The-Faulty/Argos/README.md

# Argos

Argos is a low-cost search and rescue quadruped being built for Georgia Tech
Senior Design in Spring 2026. The system is split between a Raspberry Pi 4
running ROS 2 Humble and an ESP32-class controller handling the fast control loop.

## Current expo focus

The current design expo target is intentionally narrow:

- stable stand and walk
- live RPLiDAR + RealSense bring-up
- real-time mapping in RViz

Gazebo, thermal, gas mapping, and higher-level mission logic are optional
future work, not the current critical path.

## Current workspace

- `ros2_ws/src/argos_control`: ROS 2 package wrapper and node entry points
- `ros2_ws/src/argos_mission`: ROS 2 package wrapper for mission/perception bench nodes
- `ros2_ws/src/quadruped_bringup`: launch files and sensor bring-up assets
- `ros2_ws/src/argos_description`: robot description, frames, meshes, and RViz assets
- `ros2_ws/argos_control`: leg math, control helpers, and single-leg bench tools
- `ros2_ws/argos_mission`: mission state, gas hazard map, and thermal demo nodes
- `firmware/esp32c6`: ESP-IDF + micro-ROS firmware for the C6 (servos, IMU, gas)
- `dashboard`: React/Node web dashboard served from the Pi — see `docs/dashboard_guide.md`

## Physical Robot Bring-up

The repo now includes physical bring-up scripts in `quadruped_bringup`:

- `ros2 run quadruped_bringup argos_component_check preflight`
- `ros2 run quadruped_bringup argos_component_check full --include-thermal`
- `ros2 run quadruped_bringup argos_joint_jog --bidirectional`

Primary docs:

- `docs/build_guide.md`
- `docs/component_test_guide.md`
- `docs/pi_minimal_setup.md` for the current Pi + HUZZAH32, no-sensor state

## Development environment

The repo includes a Dockerfile, Docker Compose service, and VS Code devcontainer
setup for a ROS 2 Humble workflow.

Typical flow:

```bash
docker compose build
docker compose up -d
cd /workspace/ros2_ws
colcon build --symlink-install
source install/setup.bash
```

## Sensor bring-up

LiDAR only:

```bash
ros2 launch quadruped_bringup rplidar.launch.py
ros2 launch quadruped_bringup view_lidar.launch.py
```

RealSense only:

```bash
ros2 launch quadruped_bringup realsense.launch.py
ros2 launch quadruped_bringup view_camera.launch.py
```

Both sensors:

```bash
ros2 launch quadruped_bringup sensors.launch.py
```

Robot description only:

```bash
ros2 launch quadruped_bringup state_publisher.launch.py start_rviz:=true
```

Control stack only:

```bash
ros2 launch quadruped_bringup control_stack.launch.py
```

Full stack:

```bash
ros2 launch quadruped_bringup full_system.launch.py enable_esp32:=true start_rviz:=true
```

Expo demo stack:

```bash
ros2 launch quadruped_bringup expo_demo.launch.py enable_esp32:=true start_demo_commander:=true
```

Mission stack only:

```bash
ros2 launch quadruped_bringup mission_stack.launch.py
```

Full stack with mission nodes:

```bash
ros2 launch quadruped_bringup full_system.launch.py enable_esp32:=true enable_mission:=true start_rviz:=true
```

## Web dashboard

The dashboard replaces the retired `web/leg_viz/` single-leg tool with a
full-robot control + telemetry panel. Launch it with the rest of the
stack:

```bash
ros2 launch quadruped_bringup full_system.launch.py enable_esp32:=true enable_dashboard:=true
```

Then open `http://<pi-ip>:8787` in a browser on the same LAN. Full setup
and feature walkthrough: `docs/dashboard_guide.md`.

## Notes

- `ROS_DOMAIN_ID` is set to `42` to match the Pi/ESP32-C6 design.
- On the Pi, the intended serial aliases are `/dev/ttyLIDAR` and `/dev/ttyESP32`.
- The control library is now wrapped as a ROS 2 package so `colcon` can see it.
- The web dashboard (React + Node) is documented in `docs/dashboard_guide.md`
  and listens on port `8787`; `rosbridge_websocket` on `9090` is bound to
  localhost (the Node server proxies).
- The mission bench stack is optional and not part of the current expo-critical path.
- The ROS 2 topic contract is documented in `docs/ros2_topic_contract.md`.
- The Pi device and bring-up contract is documented in `docs/pi_hardware_contract.md`.
- The recommended expo-critical execution order is documented in `docs/expo_execution_plan.md`.
- The single source-of-truth expo checklist is documented in `docs/expo_master_todo.md`.
- The repeatable demo launch flow is documented in `docs/expo_demo_runbook.md`.
- The architecture, safety, terrain, and scope talking points are documented in `docs/expo_story.md`.
- The end-to-end build instructions (Pi + ESP32 + sensors) are documented in `docs/build_guide.md`.
