The-Faulty/Argos/ros2_ws/src/Argos_description/meshes/lidar_link_1.stl

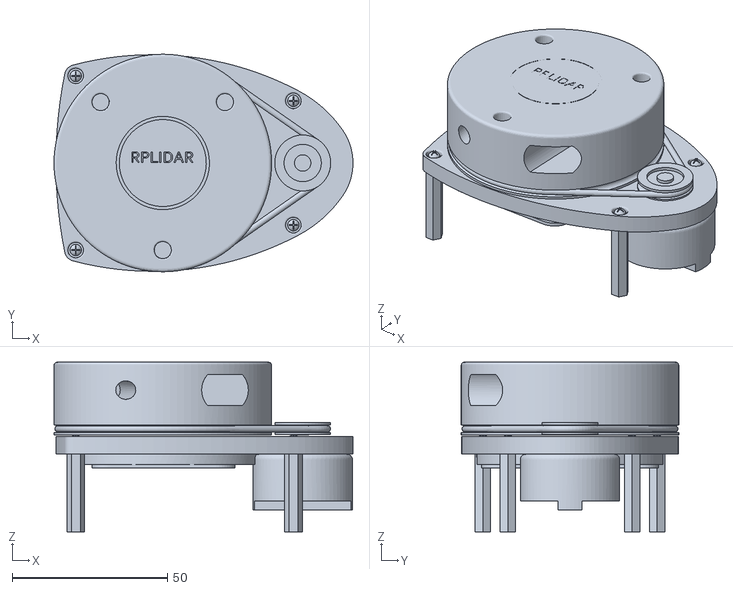
[picture p1: CAD file, 2026-04-22]
ros2_ws/src/Argos_description/meshes/lidar_link_1.stl
96.2 x 70.0 x 54.6
