The-Faulty/Argos/ros2_ws/src/Argos_description/meshes/chassis_top_front_1.stl

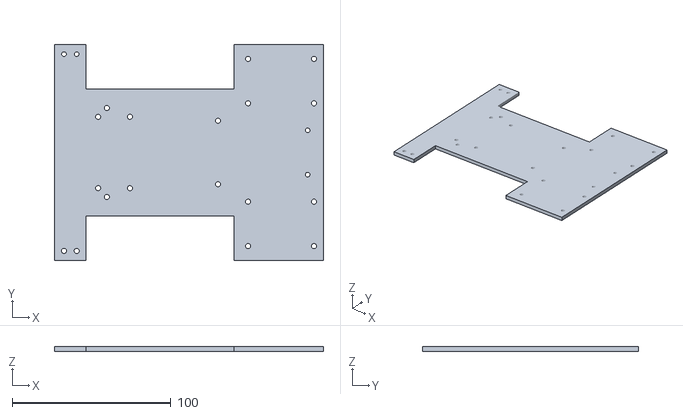
[picture p2: CAD file, 2026-04-22]
ros2_ws/src/Argos_description/meshes/chassis_top_front_1.stl
169.5 x 136.0 x 3.00
