The-Faulty/Argos/ros2_ws/src/Argos_description/meshes/RR_femur_link_1.stl

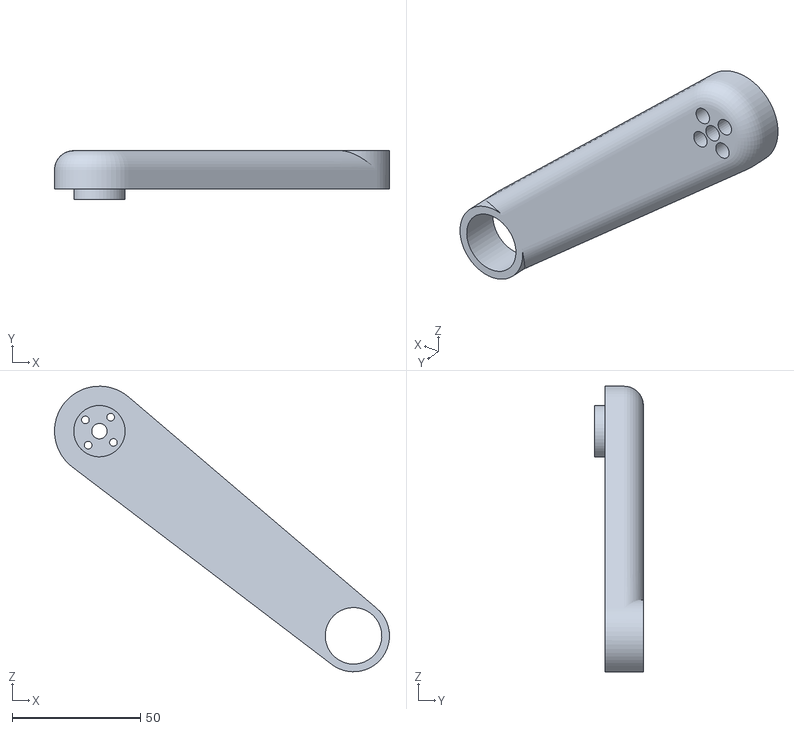
[picture p3: CAD file, 2026-04-19]
ros2_ws/src/Argos_description/meshes/RR_femur_link_1.stl
130.4 x 19.0 x 111.1
