The-Faulty/Argos/ros2_ws/src/Argos_description/meshes/chassis_side_right__1__1.stl

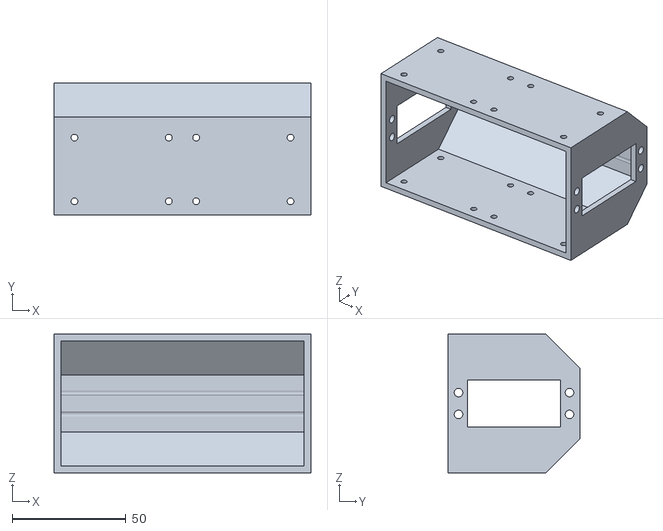
[picture p4: CAD file, 2026-04-19]
ros2_ws/src/Argos_description/meshes/chassis_side_right__1__1.stl
113.0 x 58.0 x 61.0
