The-Faulty/Argos/ros2_ws/src/Argos_description/meshes/RR_tibia_link_1.stl

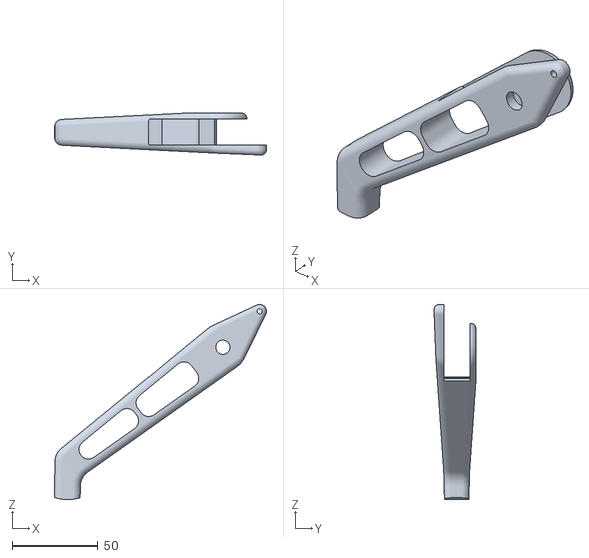
[picture p5: CAD file, 2026-04-19]
ros2_ws/src/Argos_description/meshes/RR_tibia_link_1.stl
123.7 x 24.4 x 113.8
