The-Faulty/Argos/ros2_ws/src/Argos_description/meshes/FR_coxa_link_1.stl

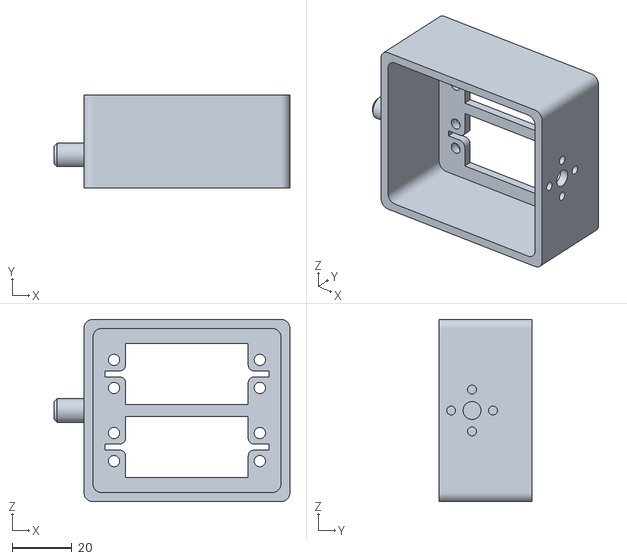
[picture p6: CAD file, 2026-04-19]
ros2_ws/src/Argos_description/meshes/FR_coxa_link_1.stl
79.0 x 31.0 x 61.0
