The-Faulty/Argos/ros2_ws/src/Argos_description/meshes/chassis_cam_mount_1.stl

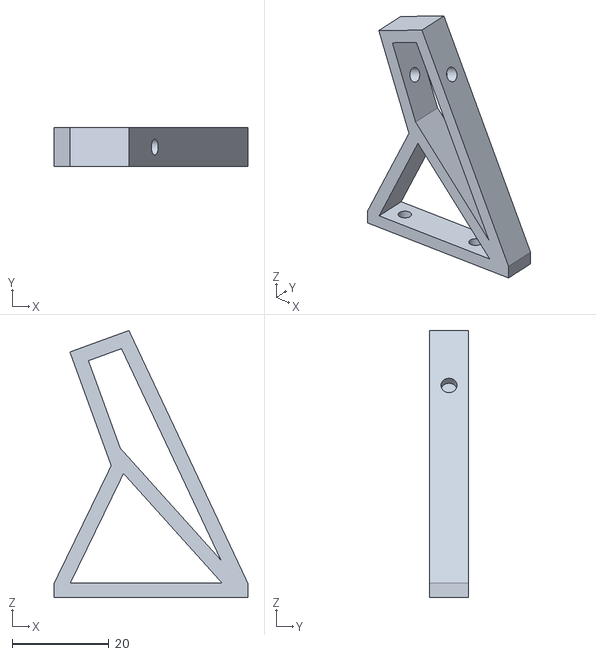
[picture p7: CAD file, 2026-04-19]
ros2_ws/src/Argos_description/meshes/chassis_cam_mount_1.stl
40.0 x 8.00 x 55.2
