The-Faulty/Argos/ros2_ws/src/Argos_description/meshes/FL_femur_link_1.stl

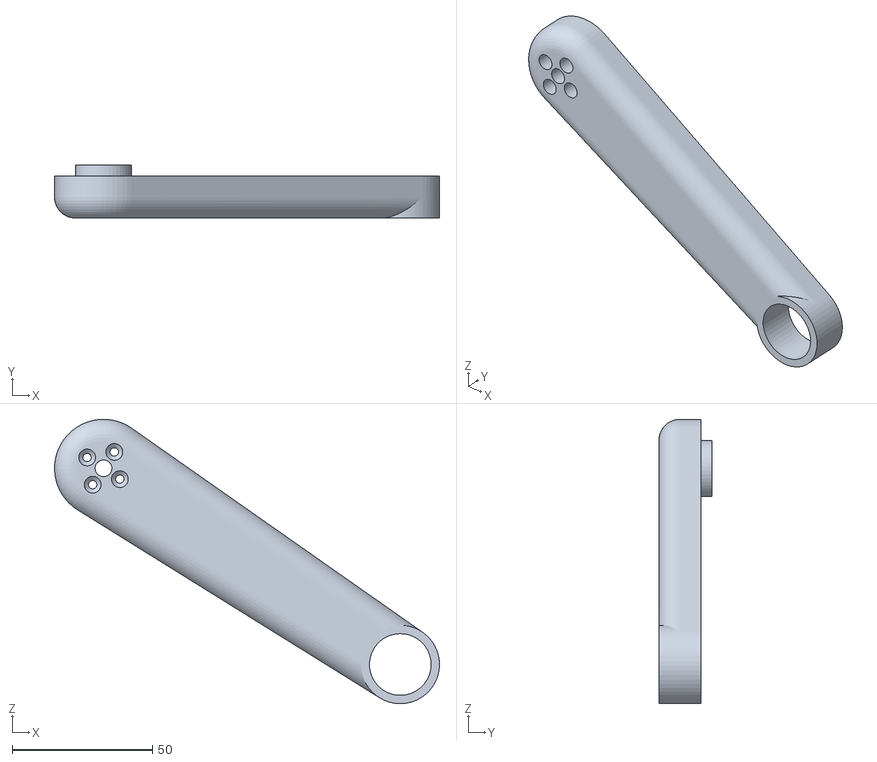
[picture p8: CAD file, 2026-04-19]
ros2_ws/src/Argos_description/meshes/FL_femur_link_1.stl
137.4 x 19.0 x 101.5
