The-Faulty/Argos/ros2_ws/src/Argos_description/meshes/RL_150mm_linkage_1.stl

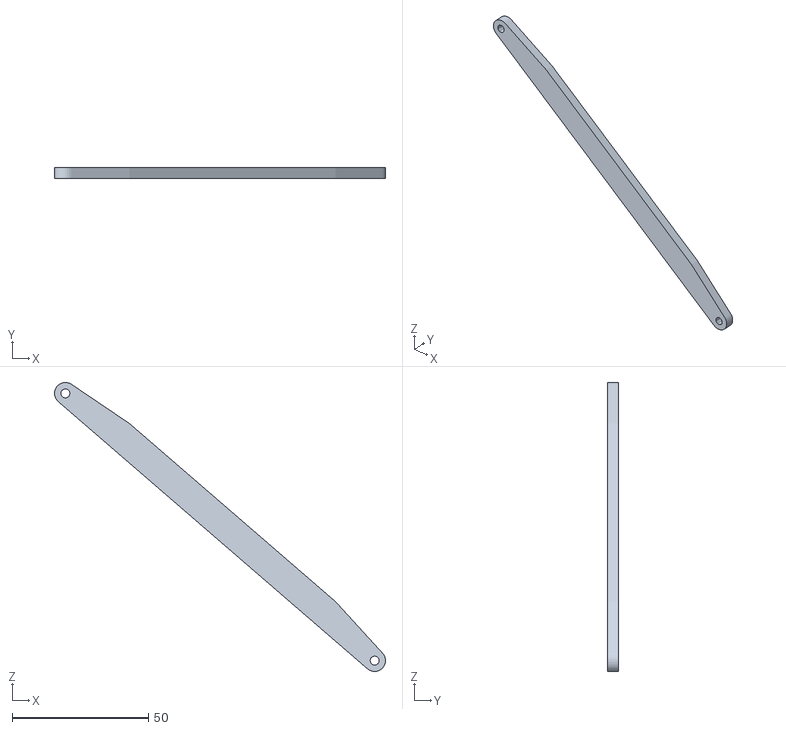
[picture p9: CAD file, 2026-04-19]
ros2_ws/src/Argos_description/meshes/RL_150mm_linkage_1.stl
121.5 x 4.00 x 106.1
