The-Faulty/Argos/ros2_ws/src/Argos_description/meshes/FR_tibia_link_1.stl

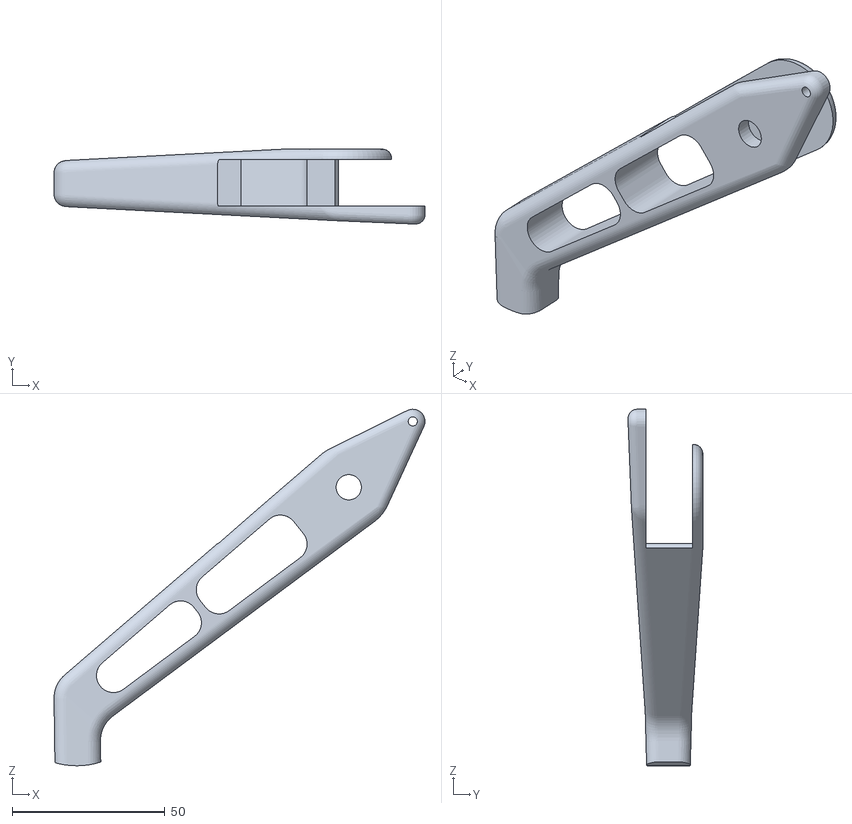
[picture p10: CAD file, 2026-04-19]
ros2_ws/src/Argos_description/meshes/FR_tibia_link_1.stl
121.3 x 24.4 x 116.6
