The-Faulty/Argos/ros2_ws/src/Argos_description/meshes/RR_30mm_linkage_1.stl

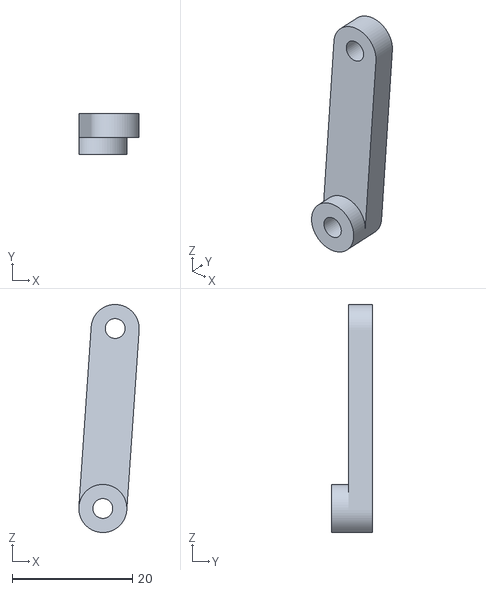
[picture p11: CAD file, 2026-04-19]
ros2_ws/src/Argos_description/meshes/RR_30mm_linkage_1.stl
10.0 x 6.80 x 37.9
