The-Faulty/Argos/ros2_ws/src/Argos_description/meshes/FL_150mm_linkage_1.stl

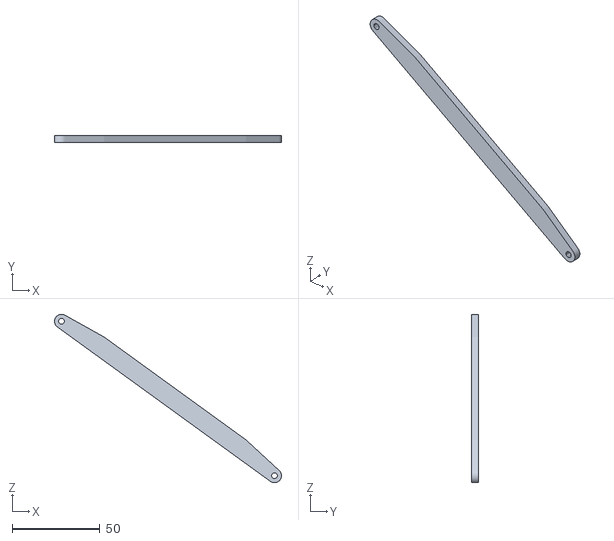
[picture p12: CAD file, 2026-04-19]
ros2_ws/src/Argos_description/meshes/FL_150mm_linkage_1.stl
129.4 x 4.00 x 96.0
