The-Faulty/Argos/ros2_ws/src/Argos_description/meshes/chassis_back_1.stl

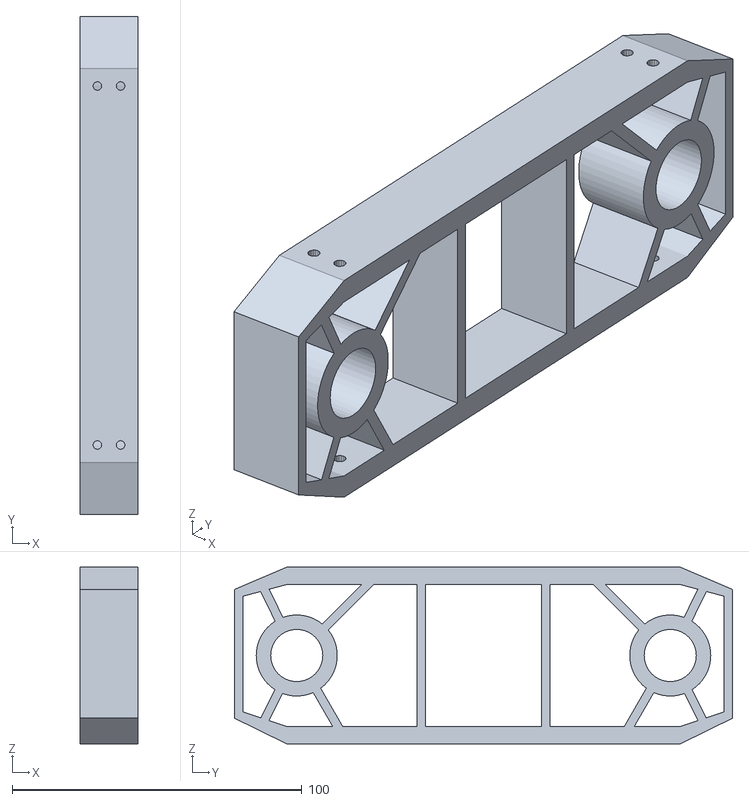
[picture p13: CAD file, 2026-04-19]
ros2_ws/src/Argos_description/meshes/chassis_back_1.stl
20.0 x 172.0 x 61.0
