The-Faulty/Argos/ros2_ws/src/Argos_description/meshes/camera_link_1.stl

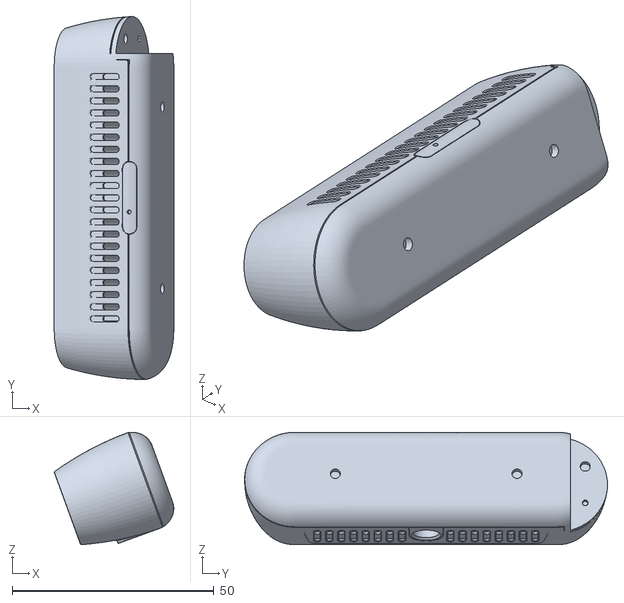
[picture p14: CAD file, 2026-04-19]
ros2_ws/src/Argos_description/meshes/camera_link_1.stl
29.6 x 89.9 x 27.9
