The-Faulty/Argos/ros2_ws/src/Argos_description/meshes/FR_30mm_linkage_1.stl

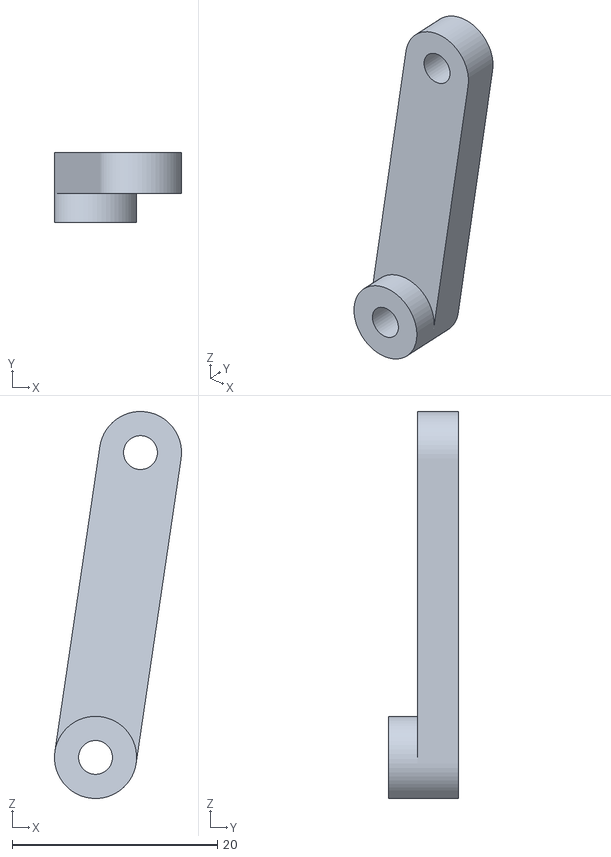
[picture p15: CAD file, 2026-04-19]
ros2_ws/src/Argos_description/meshes/FR_30mm_linkage_1.stl
12.4 x 6.80 x 37.7
