The-Faulty/Argos/ros2_ws/src/Argos_description/meshes/FL_shoulder_link_1.stl

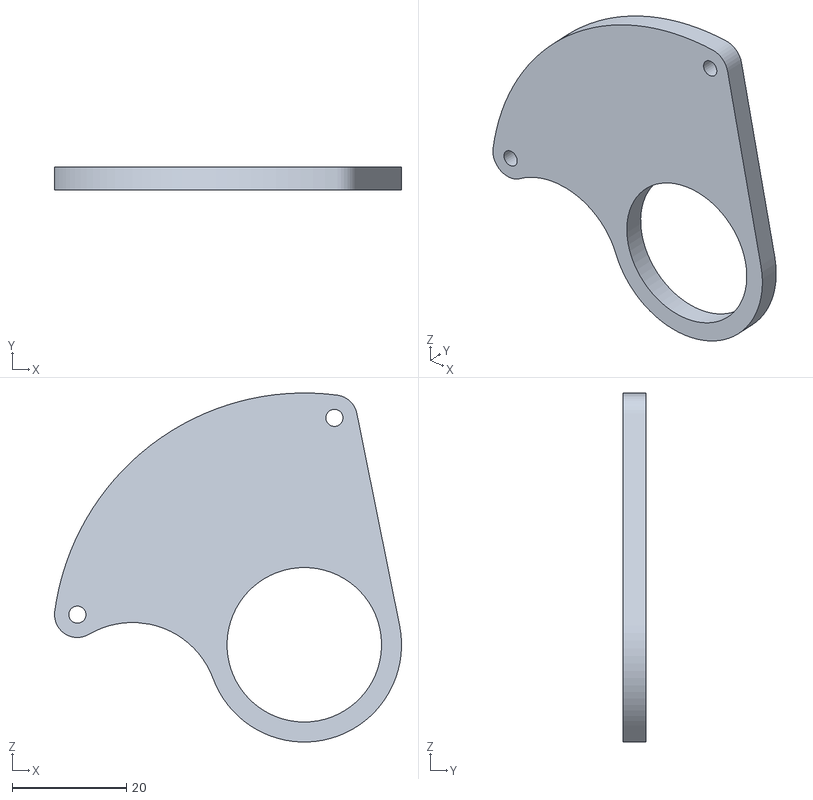
[picture p16: CAD file, 2026-04-19]
ros2_ws/src/Argos_description/meshes/FL_shoulder_link_1.stl
60.6 x 4.00 x 61.0
