The-Faulty/Argos/ros2_ws/src/Argos_description/meshes/RL_30mm_linkage_1.stl

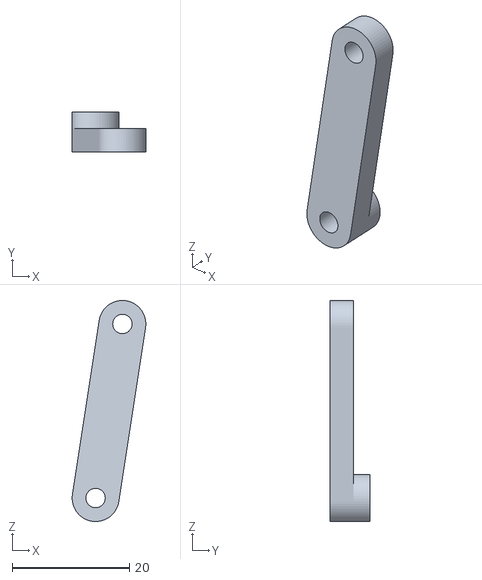
[picture p19: CAD file, 2026-04-19]
ros2_ws/src/Argos_description/meshes/RL_30mm_linkage_1.stl
12.6 x 6.80 x 37.6
