The-Faulty/Argos/(list of files, cad)

Other CAD files:
ros2_ws/src/Argos_description/meshes/chassis_top_back_1.stl
ros2_ws/src/Argos_description/meshes/RL_coxa_link_1.stl
ros2_ws/src/Argos_description/meshes/RL_femur_link_1.stl
ros2_ws/src/Argos_description/meshes/RR_coxa_link_1.stl
ros2_ws/src/Argos_description/meshes/chassis_side_left_1.stl
ros2_ws/src/Argos_description/meshes/base_link.stl
ros2_ws/src/Argos_description/meshes/FR_femur_link_1.stl
ros2_ws/src/Argos_description/meshes/RL_tibia_link_1.stl
ros2_ws/src/Argos_description/meshes/RR_150mm_linkage_1.stl
ros2_ws/src/Argos_description/meshes/FL_coxa_link_1.stl
ros2_ws/src/Argos_description/meshes/FL_tibia_link_1.stl
ros2_ws/src/Argos_description/meshes/chassis_cam_mount_2.stl
ros2_ws/src/Argos_description/meshes/FR_shoulder_link_1.stl
ros2_ws/src/Argos_description/meshes/chassis_bottom_1.stl
ros2_ws/src/Argos_description/meshes/FR_150mm_linkage_1.stl
ros2_ws/src/Argos_description/meshes/FL_30mm_linkage_1.stl
ros2_ws/src/Argos_description/meshes/RL_shoulder_link_1.stl
