The-Faulty/Argos/ros2_ws/argos_control/gait_planner_node.py

"""Turn body commands into joint targets for crouch, stand, crawl, and trot."""

from dataclasses import dataclass

import numpy as np
import rclpy
from geometry_msgs.msg import PoseArray, Twist
from rcl_interfaces.msg import SetParametersResult
from rclpy.node import Node
from sensor_msgs.msg import Imu, JointState
from std_msgs.msg import Bool, Int32MultiArray, String
from transforms3d.euler import euler2mat

from .Config import Configuration
from .Kinematics import four_legs_inverse_kinematics
from .control_core import GaitController, State, StanceController, SwingController
from .ros_support import (
    TOPICS,
    clamp,
    crouch_joint_matrix,
    euler_from_imu,
    int32_multiarray_from_values,
    joint_state_from_matrix,
    matrix_from_pose_array,
    pose_array_from_matrix,
    values_from_int32_multiarray,
    zero_twist,
)


@dataclass
class MotionCommand:
    """One sanitized motion request for a single control tick."""
    horizontal_velocity: np.ndarray  # [vx, vy] in m/s
    yaw_rate: float                  # rad/s
    height: float                    # absolute body height in meters (negative = below hip)
    pitch: float                     # body pitch in radians
    roll: float                      # body roll in radians


class GaitPlannerNode(Node):
    """Converts cmd_vel Twist messages into raw joint angles for the safety node.

    Data flow: cmd_vel -> build_command -> step_gait / stand -> IK -> raw joint publish
    Modes: crouch, stand, crawl (one foot), trot (diagonal pairs)
    """

    def __init__(self):
        super().__init__("gait_planner_node")

        self.declare_parameter("command_topic", TOPICS.muxed_cmd_vel)
        self.declare_parameter("gait_mode_topic", TOPICS.gait_mode)
        self.declare_parameter("joint_command_raw_topic", TOPICS.joint_command_raw)
        self.declare_parameter("imu_topic", TOPICS.imu_raw)
        self.declare_parameter("estop_topic", TOPICS.estop)
        self.declare_parameter("update_rate_hz", 50.0)
        self.declare_parameter("default_mode", "crouch")
        self.declare_parameter("max_height_offset_m", 0.0)
        self.declare_parameter("use_imu_stabilization", True)
        self.declare_parameter("imu_filter_alpha", 0.15)
        self.declare_parameter("stabilization_roll_gain", 0.6)
        self.declare_parameter("stabilization_pitch_gain", 0.6)
        self.declare_parameter("stabilization_max_correction_rad", 0.25)
        self.declare_parameter("enable_push_recovery", True)
        self.declare_parameter("push_recovery_tilt_threshold_rad", 0.18)
        self.declare_parameter("push_recovery_hold_s", 1.0)
        self.declare_parameter("recovery_stance_scale_x", 1.0)
        self.declare_parameter("recovery_stance_scale_y", 1.0)
        self.declare_parameter("recovery_height_offset_m", 0.0)
        self.declare_parameter("foothold_candidate_topic", TOPICS.foothold_candidates)
        self.declare_parameter(
            "foothold_contact_modes_topic", TOPICS.foothold_contact_modes
        )
        self.declare_parameter("foothold_adjusted_topic", TOPICS.foothold_adjusted)
        self.declare_parameter("foothold_status_topic", TOPICS.foothold_status)
        self.declare_parameter("enable_foothold_adjustments", True)
        self.declare_parameter("block_on_unsafe_footholds", False)
        self.declare_parameter("foothold_update_timeout_s", 0.4)

        # Dashboard-tuneable gait parameters. These map into self.config so
        # that runtime edits via rosbridge SetParameters take effect on the
        # next gait tick without a node restart. Units match the dashboard's
        # GAIT_TUNABLE_PARAMS: delta_* in mm, swing_time in ms, rotate cap in rad/s.
        tmp_config = Configuration()
        self.declare_parameter("delta_x_mm", tmp_config.delta_x * 1000.0)
        self.declare_parameter("delta_y_mm", tmp_config.delta_y * 1000.0)
        self.declare_parameter("swing_time_ms", tmp_config.swing_time * 1000.0)
        self.declare_parameter("rotate_rate_max", tmp_config.max_yaw_rate)
        # Body height (mm, negative downward). The dashboard Body-height
        # slider POSTs here; value is negated at read time because self.config
        # stores it in meters with the measured negative convention.
        self.declare_parameter("default_z_ref_mm", tmp_config.default_z_ref * 1000.0)

        command_topic = self.get_parameter("command_topic").value
        gait_mode_topic = self.get_parameter("gait_mode_topic").value
        joint_command_raw_topic = self.get_parameter("joint_command_raw_topic").value
        imu_topic = self.get_parameter("imu_topic").value
        estop_topic = self.get_parameter("estop_topic").value
        update_rate_hz = float(self.get_parameter("update_rate_hz").value)

        self.max_height_offset_m = float(self.get_parameter("max_height_offset_m").value)
        self.use_imu_stabilization = bool(self.get_parameter("use_imu_stabilization").value)
        # Clamp filter alpha to [0, 1] so bad param values don't blow up the filter
        self.imu_filter_alpha = clamp(
            float(self.get_parameter("imu_filter_alpha").value), 0.0, 1.0
        )
        self.stabilization_roll_gain = max(
            0.0, float(self.get_parameter("stabilization_roll_gain").value)
        )
        self.stabilization_pitch_gain = max(
            0.0, float(self.get_parameter("stabilization_pitch_gain").value)
        )
        self.stabilization_max_correction_rad = max(
            0.0, float(self.get_parameter("stabilization_max_correction_rad").value)
        )
        self.enable_push_recovery = bool(self.get_parameter("enable_push_recovery").value)
        self.push_recovery_tilt_threshold_rad = max(
            0.0, float(self.get_parameter("push_recovery_tilt_threshold_rad").value)
        )
        self.push_recovery_hold_ns = int(
            max(0.0, float(self.get_parameter("push_recovery_hold_s").value)) * 1e9
        )
        self.recovery_stance_scale_x = max(
            1.0, float(self.get_parameter("recovery_stance_scale_x").value)
        )
        self.recovery_stance_scale_y = max(
            1.0, float(self.get_parameter("recovery_stance_scale_y").value)
        )
        self.recovery_height_offset_m = float(
            self.get_parameter("recovery_height_offset_m").value
        )
        self.enable_foothold_adjustments = bool(
            self.get_parameter("enable_foothold_adjustments").value
        )
        self.block_on_unsafe_footholds = bool(
            self.get_parameter("block_on_unsafe_footholds").value
        )
        self.foothold_update_timeout_ns = int(
            max(0.0, float(self.get_parameter("foothold_update_timeout_s").value)) * 1e9
        )
        foothold_candidate_topic = self.get_parameter("foothold_candidate_topic").value
        foothold_contact_modes_topic = self.get_parameter(
            "foothold_contact_modes_topic"
        ).value
        foothold_adjusted_topic = self.get_parameter("foothold_adjusted_topic").value
        foothold_status_topic = self.get_parameter("foothold_status_topic").value

        self.config = Configuration()
        self.state = State()
        self.gait_controller = GaitController(self.config)
        self.swing_controller = SwingController(self.config)
        self.stance_controller = StanceController(self.config)

        self.current_twist = zero_twist()
        self.current_mode = str(self.get_parameter("default_mode").value).strip().lower()
        self.estop_active = False
        # control_mode comes from the dashboard — "manual" suppresses raw joint
        # publishes while keeping the gait state machine ticking, so we don't
        # snap mid-swing when control returns to "auto".
        self.control_mode = "auto"
        self.imu_euler = np.zeros(3, dtype=float)
        self.imu_received = False
        self.push_recovery_until_ns = 0
        self.push_recovery_active = False
        self.latest_adjusted_footholds: np.ndarray | None = None
        self.latest_foothold_status = np.zeros(4, dtype=int)
        self.latest_foothold_update_ns = 0
        self.foothold_blocked = False

        # Seed foot locations to the default stand height so first IK solve is valid
        self.state.foot_locations = (
            self.config.default_stance
            + np.array([0.0, 0.0, self.config.default_z_ref])[:, np.newaxis]
        )
        self.state.height = self.config.default_z_ref

        self.raw_joint_pub = self.create_publisher(
            JointState, joint_command_raw_topic, 10
        )
        self.foothold_candidate_pub = self.create_publisher(
            PoseArray, foothold_candidate_topic, 10
        )
        self.foothold_contact_modes_pub = self.create_publisher(
            Int32MultiArray, foothold_contact_modes_topic, 10
        )
        self.create_subscription(Twist, command_topic, self._command_callback, 10)
        self.create_subscription(String, gait_mode_topic, self._mode_callback, 10)
        self.create_subscription(
            String, TOPICS.control_mode, self._control_mode_callback, 10
        )
        self.create_subscription(Bool, estop_topic, self._estop_callback, 10)
        self.create_subscription(Imu, imu_topic, self._imu_callback, 10)
        self.create_subscription(
            PoseArray, foothold_adjusted_topic, self._foothold_adjusted_callback, 10
        )
        self.create_subscription(
            Int32MultiArray, foothold_status_topic, self._foothold_status_callback, 10
        )
        self.create_timer(1.0 / update_rate_hz, self._update)

        # Seed self.config from the declared dashboard-tuneable parameters so
        # launch-time overrides (and on_set callbacks) share one code path.
        self._apply_dashboard_params()
        self.add_on_set_parameters_callback(self._on_parameter_change)

        self._apply_gait_profile(self.current_mode)

    def _apply_dashboard_params(self):
        """Copy dashboard-facing ROS parameters into self.config."""
        self.config.delta_x = float(self.get_parameter("delta_x_mm").value) / 1000.0
        self.config.delta_y = float(self.get_parameter("delta_y_mm").value) / 1000.0
        self.config.swing_time = (
            float(self.get_parameter("swing_time_ms").value) / 1000.0
        )
        self.config.max_yaw_rate = float(
            self.get_parameter("rotate_rate_max").value
        )
        self.config.default_z_ref = (
            float(self.get_parameter("default_z_ref_mm").value) / 1000.0
        )

    def _on_parameter_change(self, params):
        """Live-update self.config when the dashboard calls SetParameters.

        Every dashboard-tuneable param is re-read here so the change takes
        effect mid-gait without needing a node restart. The stabilizer /
        push-recovery attributes are consumed every tick in
        `_apply_imu_stabilization` and `_update_push_recovery`, so mutating
        them in place is enough.
        """
        for p in params:
            if p.name == "delta_x_mm":
                self.config.delta_x = float(p.value) / 1000.0
            elif p.name == "delta_y_mm":
                self.config.delta_y = float(p.value) / 1000.0
            elif p.name == "swing_time_ms":
                self.config.swing_time = float(p.value) / 1000.0
            elif p.name == "rotate_rate_max":
                self.config.max_yaw_rate = float(p.value)
            elif p.name == "default_z_ref_mm":
                self.config.default_z_ref = float(p.value) / 1000.0
            elif p.name == "use_imu_stabilization":
                self.use_imu_stabilization = bool(p.value)
            elif p.name == "imu_filter_alpha":
                self.imu_filter_alpha = clamp(float(p.value), 0.0, 1.0)
            elif p.name == "stabilization_roll_gain":
                self.stabilization_roll_gain = max(0.0, float(p.value))
            elif p.name == "stabilization_pitch_gain":
                self.stabilization_pitch_gain = max(0.0, float(p.value))
            elif p.name == "stabilization_max_correction_rad":
                self.stabilization_max_correction_rad = max(0.0, float(p.value))
            elif p.name == "enable_push_recovery":
                self.enable_push_recovery = bool(p.value)
            elif p.name == "push_recovery_tilt_threshold_rad":
                self.push_recovery_tilt_threshold_rad = max(0.0, float(p.value))
        return SetParametersResult(successful=True)

    def _command_callback(self, msg: Twist):
        # Just store it — the timer loop reads it every tick
        self.current_twist = msg

    def _mode_callback(self, msg: String):
        mode = msg.data.strip().lower()
        if not mode:
            return
        if mode not in {"crouch", "stand", "crawl", "trot"}:
            self.get_logger().warning(f"Ignoring unsupported gait mode '{mode}'")
            return
        if mode == self.current_mode:
            return

        prev_mode = self.current_mode
        self.current_mode = mode
        self._apply_gait_profile(mode)

        # Only reset the tick counter when starting a walking gait from a static pose.
        # If we're already walking (crawl ↔ trot), leave ticks running so legs in
        # mid-swing don't freeze or jump.
        static_modes = {"crouch", "stand"}
        if prev_mode in static_modes and mode not in static_modes:
            self.state.ticks = 0

        self.get_logger().info(f"Switched gait mode: {prev_mode} -> {mode}")

    def _estop_callback(self, msg: Bool):
        # Immediately freeze motion when e-stop fires
        self.estop_active = bool(msg.data)

    def _control_mode_callback(self, msg: String):
        """Handle manual/auto mode toggles from the dashboard.

        In manual mode the dashboard owns joint targets, so we stop
        publishing raw commands. On the manual->auto transition we force
        the mode to crouch and re-apply the crouch gait profile so the
        robot doesn't jerk mid-swing when control returns to the gait planner.
        """
        new_mode = msg.data.strip().lower()
        if new_mode not in {"auto", "manual"}:
            self.get_logger().warning(
                f"Ignoring unsupported control_mode '{msg.data}'"
            )
            return
        if new_mode == self.control_mode:
            return

        prev_mode = self.control_mode
        self.control_mode = new_mode
        self.get_logger().info(
            f"Control mode: {prev_mode} -> {new_mode}"
        )

        if prev_mode == "manual" and new_mode == "auto":
            # Force crouch so IK has a known-good starting pose on re-entry
            self.current_mode = "crouch"
            self._apply_gait_profile("crouch")
            self.state.ticks = 0

    def _imu_callback(self, msg: Imu):
        sample = np.asarray(euler_from_imu(msg), dtype=float)
        if not self.imu_received:
            # Seed the filter with the first sample instead of starting at zero
            self.imu_euler = sample
            self.imu_received = True
            return
        # Low-pass filter — alpha controls how fast the estimate tracks new readings
        self.imu_euler = (
            (1.0 - self.imu_filter_alpha) * self.imu_euler
            + self.imu_filter_alpha * sample
        )

    def _foothold_adjusted_callback(self, msg: PoseArray):
        try:
            self.latest_adjusted_footholds = matrix_from_pose_array(msg)
            self.latest_foothold_update_ns = self.get_clock().now().nanoseconds
        except ValueError as exc:
            self.get_logger().warning(
                f"Ignoring malformed foothold adjustment message: {exc}"
            )

    def _foothold_status_callback(self, msg: Int32MultiArray):
        try:
            self.latest_foothold_status = values_from_int32_multiarray(
                msg, expected_size=4
            )
            self.latest_foothold_update_ns = self.get_clock().now().nanoseconds
        except ValueError as exc:
            self.get_logger().warning(
                f"Ignoring malformed foothold status message: {exc}"
            )

    def _apply_gait_profile(self, mode: str):
        """Set contact phases, timing, and foot clearance for the requested gait."""
        if mode == "crawl":
            # Crawl: one foot off at a time — slowest but most stable on rough ground.
            # Keep every phase non-zero so each single-leg swing column is reachable.
            self.config.contact_phases = np.array(
                [[0, 1, 1, 1], [1, 0, 1, 1], [1, 1, 0, 1], [1, 1, 1, 0]]
            )
            self.config.swing_time = 0.25
            self.config.overlap_time = self.config.swing_time
            self.config.z_clearance = 0.04
        elif mode == "trot":
            # Trot: diagonal pairs (FR+RL, FL+RR) move together — faster, less stable
            self.config.contact_phases = np.array(
                [[1, 1, 1, 0], [1, 0, 0, 1], [1, 0, 0, 1], [1, 1, 1, 0]]
            )
            self.config.swing_time = 0.15
            self.config.overlap_time = 0.05
            self.config.z_clearance = 0.05
        else:
            # Stand / crouch: all feet on the ground, no swing needed
            self.config.contact_phases = np.ones((4, 4), dtype=int)
            self.config.swing_time = 0.25
            self.config.overlap_time = 0.0
            self.config.z_clearance = 0.04

    def _build_command(self, push_recovery_active: bool) -> MotionCommand:
        """Build a sanitized MotionCommand from the latest incoming Twist."""
        # Zero velocity during e-stop or push recovery — let the balance logic take over
        twist = (
            zero_twist()
            if self.estop_active or push_recovery_active
            else self.current_twist
        )
        return MotionCommand(
            horizontal_velocity=np.array(
                [
                    clamp(twist.linear.x, -self.config.max_x_velocity, self.config.max_x_velocity),
                    clamp(twist.linear.y, -self.config.max_y_velocity, self.config.max_y_velocity),
                ],
                dtype=float,
            ),
            yaw_rate=clamp(twist.angular.z, -self.config.max_yaw_rate, self.config.max_yaw_rate),
            height=self.config.default_z_ref
            + clamp(twist.linear.z, -self.max_height_offset_m, self.max_height_offset_m),
            pitch=clamp(twist.angular.y, -self.config.max_pitch, self.config.max_pitch),
            roll=clamp(twist.angular.x, -self.config.max_pitch, self.config.max_pitch),
        )

    def _update_push_recovery(self) -> bool:
        """Check body tilt and hold a wide stance if the robot was pushed. Returns True while active."""
        if not (self.enable_push_recovery and self.imu_received):
            self.push_recovery_active = False
            return False

        now_ns = self.get_clock().now().nanoseconds
        roll, pitch, _ = self.imu_euler
        tilt_exceeded = (
            abs(roll) >= self.push_recovery_tilt_threshold_rad
            or abs(pitch) >= self.push_recovery_tilt_threshold_rad
        )
        if tilt_exceeded:
            # Keep pushing the hold window forward as long as tilt is still detected
            self.push_recovery_until_ns = now_ns + self.push_recovery_hold_ns

        active = now_ns < self.push_recovery_until_ns
        if active and not self.push_recovery_active:
            self.get_logger().warning(
                "Push recovery active: holding a widened stand until tilt settles."
            )
        elif self.push_recovery_active and not active:
            self.get_logger().info("Push recovery cleared; resuming requested gait.")
        self.push_recovery_active = active
        return active

    def _imu_stabilisation_matrix(self) -> np.ndarray:
        """Build a rotation matrix that counteracts measured body tilt.

        Multiplies tilt by the gain then clamps so one bad IMU reading can't
        flip the robot over.
        """
        if not (self.use_imu_stabilization and self.imu_received):
            return np.eye(3, dtype=float)

        roll, pitch, _ = self.imu_euler
        # Negate the tilt so the correction pushes back against the lean
        correction = euler2mat(
            clamp(
                -roll * self.stabilization_roll_gain,
                -self.stabilization_max_correction_rad,
                self.stabilization_max_correction_rad,
            ),
            clamp(
                -pitch * self.stabilization_pitch_gain,
                -self.stabilization_max_correction_rad,
                self.stabilization_max_correction_rad,
            ),
            0.0,
        )
        return correction.T

    def _foot_transform_matrix(self, command: MotionCommand) -> np.ndarray:
        return self._imu_stabilisation_matrix() @ euler2mat(
            command.roll, command.pitch, 0.0
        )

    def _apply_foot_transform(
        self, foot_locations: np.ndarray, command: MotionCommand
    ) -> np.ndarray:
        return self._foot_transform_matrix(command) @ foot_locations

    def _stabilise_with_imu(self, foot_locations: np.ndarray) -> np.ndarray:
        return self._imu_stabilisation_matrix() @ foot_locations

    def _stand_foot_locations(self, height: float, push_recovery_active: bool) -> np.ndarray:
        """Build a foot position matrix for standing, widened if push recovery is active."""
        stance = self.config.default_stance.copy()
        if push_recovery_active:
            # Widen and lower slightly — gives a more stable base when the robot gets bumped
            stance[0, :] *= self.recovery_stance_scale_x
            stance[1, :] *= self.recovery_stance_scale_y
            height += self.recovery_height_offset_m
        return stance + np.array([0.0, 0.0, height])[:, np.newaxis]

    def _nominal_touchdown_location(
        self, leg_index: int, command: MotionCommand
    ) -> np.ndarray:
        touchdown = self.swing_controller.raibert_touchdown_location(
            leg_index, command
        ).copy()
        touchdown[2] = command.height
        return touchdown

    def _candidate_touchdown_locations(
        self, command: MotionCommand, contact_modes: np.ndarray
    ) -> np.ndarray:
        candidates = self.state.foot_locations.copy()
        for leg_index in range(4):
            if contact_modes[leg_index] == 0:
                candidates[:, leg_index] = self._nominal_touchdown_location(
                    leg_index, command
                )
        return candidates

    def _publish_foothold_candidates(
        self,
        candidate_planned: np.ndarray,
        contact_modes: np.ndarray,
        foot_transform: np.ndarray,
    ) -> None:
        stamp = self.get_clock().now().to_msg()
        candidate_base = foot_transform @ candidate_planned
        self.foothold_candidate_pub.publish(
            pose_array_from_matrix(stamp, candidate_base)
        )
        self.foothold_contact_modes_pub.publish(
            int32_multiarray_from_values(contact_modes)
        )

    def _foothold_data_fresh(self) -> bool:
        if self.latest_adjusted_footholds is None or self.foothold_update_timeout_ns <= 0:
            return False
        now_ns = self.get_clock().now().nanoseconds
        return (now_ns - self.latest_foothold_update_ns) <= self.foothold_update_timeout_ns

    def _set_foothold_blocked(self, blocked: bool) -> None:
        if blocked and not self.foothold_blocked:
            self.get_logger().warning(
                "Foothold checker rejected the active touchdown; holding gait phase."
            )
        elif self.foothold_blocked and not blocked:
            self.get_logger().info("Foothold checker cleared; resuming gait.")
        self.foothold_blocked = blocked

    def _resolved_touchdown(
        self,
        leg_index: int,
        nominal_touchdown: np.ndarray,
        foot_transform: np.ndarray,
    ) -> np.ndarray:
        if not (self.enable_foothold_adjustments and self._foothold_data_fresh()):
            return nominal_touchdown
        if self.latest_adjusted_footholds is None:
            return nominal_touchdown
        if self.latest_foothold_status[leg_index] <= 0:
            return nominal_touchdown

        adjusted_base = self.latest_adjusted_footholds[:, leg_index]
        return foot_transform.T @ adjusted_base

    def _should_block_unsafe_footholds(self, contact_modes: np.ndarray) -> bool:
        if not (self.block_on_unsafe_footholds and self._foothold_data_fresh()):
            return False
        swing_mask = np.asarray(contact_modes, dtype=int) == 0
        return bool(np.any(swing_mask) and np.any(self.latest_foothold_status[swing_mask] < 0))

    def _step_gait(
        self,
        command: MotionCommand,
        contact_modes: np.ndarray,
        foot_transform: np.ndarray,
    ) -> np.ndarray:
        """Advance all four legs by one tick and return updated foot positions."""
        new_foot_locations = np.zeros((3, 4), dtype=float)

        for leg_index in range(4):
            if contact_modes[leg_index] == 1:
                new_location = self.stance_controller.next_foot_location(
                    leg_index, self.state, command
                )
            else:
                swing_proportion = (
                    self.gait_controller.subphase_ticks(self.state.ticks)
                    / max(1, self.config.swing_ticks)
                )
                nominal_touchdown = self._nominal_touchdown_location(
                    leg_index, command
                )
                new_location = self.swing_controller.next_foot_location(
                    swing_proportion,
                    leg_index,
                    self.state,
                    command,
                    touchdown_override=self._resolved_touchdown(
                        leg_index, nominal_touchdown, foot_transform
                    ),
                )
            new_foot_locations[:, leg_index] = new_location

        return new_foot_locations

    def _update(self):
        """Main 50 Hz control loop: plan foot positions, run IK, and publish joint angles."""
        push_recovery_active = self._update_push_recovery()
        command = self._build_command(push_recovery_active)
        foothold_blocked = False
        contact_modes = np.ones(4, dtype=int)
        foot_transform = self._foot_transform_matrix(command)

        try:
            if self.current_mode == "crouch":
                # Crouch uses zero angles directly — no IK needed
                angles = crouch_joint_matrix(self.config)
                # Keep foot locations at default stand height so the next mode
                # transition has a valid starting pose for the swing controller
                planned = self._stand_foot_locations(
                    self.config.default_z_ref, push_recovery_active=False
                )
                contact_modes = np.ones(4, dtype=int)
                candidate_planned = planned.copy()
                rotated = planned.copy()
            else:
                if self.current_mode == "stand" or self.estop_active or push_recovery_active:
                    planned = self._stand_foot_locations(
                        command.height, push_recovery_active=push_recovery_active
                    )
                    contact_modes = np.ones(4, dtype=int)
                    candidate_planned = planned.copy()
                else:
                    # Active gait — advance each leg one tick
                    contact_modes = self.gait_controller.contacts(self.state.ticks)
                    candidate_planned = self._candidate_touchdown_locations(
                        command, contact_modes
                    )
                    foothold_blocked = self._should_block_unsafe_footholds(
                        contact_modes
                    )
                    if foothold_blocked:
                        planned = self.state.foot_locations.copy()
                    else:
                        planned = self._step_gait(
                            command, contact_modes, foot_transform
                        )

                # Apply operator body tilt (roll/pitch joystick) then IMU correction
                rotated = foot_transform @ planned
                angles = four_legs_inverse_kinematics(rotated, self.config)

        except ValueError as exc:
            # IK workspace miss — skip this tick rather than crashing the node
            self.get_logger().warning(f"Skipping gait update: {exc}")
            return

        self._set_foothold_blocked(foothold_blocked)
        self._publish_foothold_candidates(candidate_planned, contact_modes, foot_transform)
        self.state.foot_locations = planned
        self.state.rotated_foot_locations = rotated
        self.state.joint_angles = angles
        self.state.height = command.height
        self.state.roll = command.roll
        self.state.pitch = command.pitch
        self.state.yaw_rate = command.yaw_rate
        self.state.horizontal_velocity = command.horizontal_velocity
        if not foothold_blocked:
            self.state.ticks += 1

        msg = joint_state_from_matrix(self.get_clock().now().to_msg(), angles)
        # In manual mode the dashboard_bridge_node publishes /joint_command/raw
        # directly; the gait state machine still runs so a manual->auto
        # transition has fresh foot positions to continue from.
        if self.control_mode != "manual":
            self.raw_joint_pub.publish(msg)


def main(args=None):
    rclpy.init(args=args)
    node = GaitPlannerNode()
    try:
        rclpy.spin(node)
    finally:
        node.destroy_node()
        rclpy.shutdown()


if __name__ == "__main__":
    main()
