The-Faulty/Argos/ros2_ws/argos_control/joint_command_publisher_node.py

"""Buffer the latest safe joint command and re-publish it at a steady 100 Hz."""

import rclpy
from rclpy.node import Node
from sensor_msgs.msg import JointState

from .Config import Configuration
from .ros_support import (
    TOPICS,
    crouch_joint_matrix,
    joint_state_from_matrix,
    joint_state_from_positions,
    matrix_to_ordered_positions,
    ordered_positions_to_matrix,
    positions_from_joint_state,
    urdf_joint_matrix,
)


class JointCommandPublisherNode(Node):
    """Re-publishes the latest safe joint command at a steady 100 Hz.

    The safety node runs at 50 Hz but the MCU expects 100 Hz packets.
    This node decouples those rates by holding the last command and repeating it.
    Also mirrors to /joint_states so RViz shows the live robot pose.
    """

    def __init__(self):
        super().__init__("joint_command_publisher_node")

        self.declare_parameter("safe_command_topic", TOPICS.joint_command_safe)
        self.declare_parameter("joint_command_topic", TOPICS.joint_command)
        self.declare_parameter("joint_states_topic", TOPICS.joint_states)
        self.declare_parameter("output_rate_hz", 100.0)
        self.declare_parameter("publish_joint_states_preview", True)

        safe_command_topic = self.get_parameter("safe_command_topic").value
        joint_command_topic = self.get_parameter("joint_command_topic").value
        joint_states_topic = self.get_parameter("joint_states_topic").value
        output_rate_hz = float(self.get_parameter("output_rate_hz").value)
        self.publish_joint_states_preview = bool(
            self.get_parameter("publish_joint_states_preview").value
        )

        self.config = Configuration()
        self.latest_positions = matrix_to_ordered_positions(
            crouch_joint_matrix(self.config)
        )

        self.command_pub = self.create_publisher(JointState, joint_command_topic, 10)
        self.joint_state_pub = self.create_publisher(JointState, joint_states_topic, 10)
        self.create_subscription(JointState, safe_command_topic, self._safe_command_callback, 10)
        self.create_timer(1.0 / output_rate_hz, self._publish)

    def _safe_command_callback(self, msg: JointState):
        try:
            self.latest_positions = positions_from_joint_state(msg)
        except (KeyError, ValueError) as exc:
            # Drop malformed messages rather than crashing or sending garbage to the MCU
            self.get_logger().warning(f"Ignoring malformed safe joint command: {exc}")

    def _publish(self):
        # Send the same command every tick — MCU gets a steady stream even when nothing changes
        stamp = self.get_clock().now().to_msg()
        msg = joint_state_from_positions(stamp, self.latest_positions)
        self.command_pub.publish(msg)
        if self.publish_joint_states_preview:
            # Mirror to /joint_states so RViz shows the current commanded pose
            try:
                preview_matrix = urdf_joint_matrix(
                    ordered_positions_to_matrix(self.latest_positions),
                    self.config,
                )
                preview_msg = joint_state_from_matrix(stamp, preview_matrix)
            except ValueError as exc:
                self.get_logger().warning(
                    f"Falling back to raw joint preview because conversion failed: {exc}"
                )
                preview_msg = msg
            self.joint_state_pub.publish(preview_msg)


def main(args=None):
    rclpy.init(args=args)
    node = JointCommandPublisherNode()
    try:
        rclpy.spin(node)
    finally:
        node.destroy_node()
        rclpy.shutdown()


if __name__ == "__main__":
    main()
