The-Faulty/Argos/firmware/esp32c6/main/esp32_serial_transport.c

// Copyright 2021 Proyectos y Sistemas de Mantenimiento SL (eProsima).
//
// Licensed under the Apache License, Version 2.0 (the "License");
// you may not use this file except in compliance with the License.
// You may obtain a copy of the License at
//
//     http://www.apache.org/licenses/LICENSE-2.0
//
// Unless required by applicable law or agreed to in writing, software
// distributed under the License is distributed on an "AS IS" BASIS,
// WITHOUT WARRANTIES OR CONDITIONS OF ANY KIND, either express or implied.
// See the License for the specific language governing permissions and
// limitations under the License.

#include <uxr/client/transport.h>

#include <driver/uart.h>
#include <driver/gpio.h>

#include "freertos/FreeRTOS.h"
#include "freertos/task.h"

#define UART_TXD  (CONFIG_MICROROS_UART_TXD)
#define UART_RXD  (CONFIG_MICROROS_UART_RXD)
#define UART_RTS  (CONFIG_MICROROS_UART_RTS)
#define UART_CTS  (CONFIG_MICROROS_UART_CTS)

// --- micro-ROS Transports ---
#define UART_BUFFER_SIZE (512)

bool esp32_serial_open(struct uxrCustomTransport * transport){
    size_t * uart_port = (size_t*) transport->args;

    uart_config_t uart_config = {
        .baud_rate = 115200,
        .data_bits = UART_DATA_8_BITS,
        .parity    = UART_PARITY_DISABLE,
        .stop_bits = UART_STOP_BITS_1,
        .flow_ctrl = UART_HW_FLOWCTRL_DISABLE,
    };

    if (uart_param_config(*uart_port, &uart_config) == ESP_FAIL) {
        return false;
    }
    if (uart_set_pin(*uart_port, UART_TXD, UART_RXD, UART_RTS, UART_CTS) == ESP_FAIL) {
        return false;
    }
    if (uart_driver_install(*uart_port, UART_BUFFER_SIZE * 2, 0, 0, NULL, 0) == ESP_FAIL) {
        return false;
    }

    return true;
}

bool esp32_serial_close(struct uxrCustomTransport * transport){
    size_t * uart_port = (size_t*) transport->args;

    return uart_driver_delete(*uart_port) == ESP_OK;
}

size_t esp32_serial_write(struct uxrCustomTransport* transport, const uint8_t * buf, size_t len, uint8_t * err){
    size_t * uart_port = (size_t*) transport->args;
    const int txBytes = uart_write_bytes(*uart_port, (const char*) buf, len);
    return txBytes;
}

size_t esp32_serial_read(struct uxrCustomTransport* transport, uint8_t* buf, size_t len, int timeout, uint8_t* err){
    size_t * uart_port = (size_t*) transport->args;
    const int rxBytes = uart_read_bytes(*uart_port, buf, len, timeout / portTICK_PERIOD_MS);
    return rxBytes;
}
