The-Faulty/Argos/ros2_ws/argos_control/single_leg_test.py

"""Single-leg bench test for Argos.

Talks straight to the PCA9685 over I2C so you can check one leg without
bringing up ROS.  Run with --sim if no hardware is attached.
"""

import argparse
import sys
import time
from math import pi, acos, atan2, sqrt, sin, cos, fmod, asin, radians, degrees

import numpy as np

try:
    from .Config import Configuration
    from .Kinematics import leg_explicit_inverse_kinematics
except ImportError:
    from Config import Configuration
    from Kinematics import leg_explicit_inverse_kinematics


PCA9685_I2C_ADDRESS = 0x00   # Argos board strap (matches firmware default)

# PCA9685 channel assignments for this test leg.
HIP_CH = 2   # hip abductor servo
TOP_CH = 1   # upper leg servo
BOT_CH = 0   # lower/bell-crank servo

# Pulse limits from the servo datasheet (microseconds).
# Adjust if the servos hit their physical endpoints before these values.
PWM_MIN_US = 370
PWM_MAX_US = 2400
PWM_FREQ = 50
SERVO_RANGE_DEG = 180.0
SERVO_CENTER_DEG = SERVO_RANGE_DEG / 2.0

# Flip a multiplier to -1 if a servo runs backward.
# Adjust an offset (degrees) if the servo neutral doesn't match the IK zero.
HIP_OFFSET = 0.0
HIP_MULTIPLIER = -1

TOP_OFFSET = 0.0
TOP_MULTIPLIER = +1

BOT_OFFSET = 0.0
BOT_MULTIPLIER = +1

# Which leg to test: 0=FR, 1=FL, 2=RR, 3=RL
LEG_INDEX = 0
LEG_NAMES = ("FR", "FL", "RR", "RL")

# Pull the bench geometry from Config.py so the script stays aligned with the
# latest measured linkage values.
_CONFIG = Configuration()
PARAMS = dict(_CONFIG.leg_params)
LEG_LATERAL_OFFSET = float(_CONFIG.LEG_ORIGINS[1, LEG_INDEX])
LEG_SAGITTAL_OFFSET_M = float(
    _CONFIG.default_stance[1, LEG_INDEX] - _CONFIG.LEG_ORIGINS[1, LEG_INDEX]
)
DEFAULT_BODY_Z_M = float(_CONFIG.default_z_ref)
DEFAULT_SAG_X_MM = int(
    round(
        (_CONFIG.default_stance[0, LEG_INDEX] - _CONFIG.LEG_ORIGINS[0, LEG_INDEX])
        * 1000.0
    )
)

# Motion settings.
STEPS_PER_MOVE = 30
STEP_DELAY_S = 0.018
STARTUP_SAG = (DEFAULT_SAG_X_MM, int(round(abs(DEFAULT_BODY_Z_M) * 1000.0)))
STARTUP_SERVO_DEG = (90.0, 90.0, 90.0)
FALLBACK_SERVO_LIMITS_DEG = np.array([
    [45.0, 135.0],
    [50.0, 115.0],
    [5.0, 180.0],
], dtype=float)
FALLBACK_COUPLED_TOP_SAMPLES_DEG = np.array([50.0, 70.0, 90.0, 102.0, 115.0], dtype=float)
FALLBACK_COUPLED_BOT_MIN_SAMPLES_DEG = np.array([10.0, 10.0, 40.0, 65.0, 85.0], dtype=float)
FALLBACK_COUPLED_BOT_MAX_SAMPLES_DEG = np.array([95.0, 125.0, 180.0, 180.0, 180.0], dtype=float)
MOCK_WALK_DWELL_S = 0.12
MOCK_WALK_SERVO_WAYPOINTS = [
    STARTUP_SERVO_DEG,
    (94.0, 82.0, 76.0),
    (100.0, 80.0, 72.0),
    (96.0, 86.0, 82.0),
    STARTUP_SERVO_DEG,
    (84.0, 98.0, 104.0),
    (80.0, 94.0, 100.0),
    STARTUP_SERVO_DEG,
]


# ── Unit-converting wrappers around Kinematics.py ─────────────────────────────
# The ROS nodes work in radians and meters.  This script uses degrees and
# millimeters so the interactive REPL stays easy to read.

def _point_to_rad(p1, p2):
    return (atan2(p2, p1) + 2 * pi) % (2 * pi)


def _wrap_to_pi(angle):
    """Wrap an angle in radians into [-pi, pi]."""
    return (angle + pi) % (2 * pi) - pi


def _rotx(angle):
    c, s = cos(angle), sin(angle)
    return np.array([[1, 0, 0], [0, c, -s], [0, s, c]])


def _ci(P1, r1, P2, r2):
    dx, dy = P2[0] - P1[0], P2[1] - P1[1]
    d = sqrt(dx * dx + dy * dy)
    if d < 1e-9 or d > r1 + r2 + 1e-9 or d < abs(r1 - r2) - 1e-9:
        return None, None
    a = (r1 * r1 - r2 * r2 + d * d) / (2 * d)
    h = sqrt(max(0, r1 * r1 - a * a))
    mx = P1[0] + a * dx / d
    my = P1[1] + a * dy / d
    px, py = -dy / d, dx / d
    return np.array([mx + h * px, my + h * py]), np.array([mx - h * px, my - h * py])


def hip_ik(r_foot, leg_index, params):
    """Solve the hip abductor and return (theta_1_deg, x_sag_m, y_sag_m)."""
    is_right = leg_index in (0, 2)
    x, y, z = float(r_foot[0]), float(r_foot[1]), float(r_foot[2])
    if is_right:
        y = -y

    R1 = pi / 2 - params["phi"]
    rf = _rotx(-R1) @ np.array([x, y, z])
    x, y, z = rf

    len_A = sqrt(y * y + z * z)
    if len_A < 1e-9:
        len_A = 1e-9

    asin_arg = sin(params["phi"]) * params["L1_hip"] / len_A
    asin_arg = max(-1.0, min(1.0, asin_arg))
    a1 = _point_to_rad(y, z)
    a2 = asin(asin_arg)
    a3 = pi - a2 - params["phi"]
    t1 = a1 + a3
    if t1 >= 2 * pi:
        t1 = fmod(t1, 2 * pi)
    t1 = _wrap_to_pi(t1)

    offset = np.array([0.0, params["L1_hip"] * cos(t1), params["L1_hip"] * sin(t1)])
    translated = np.array([x, y, z]) - offset
    R2 = t1 + params["phi"] - pi / 2
    sag = _rotx(-R2) @ translated
    x_sag, _, z_sag = sag
    return degrees(t1), x_sag, -z_sag


def sag_ik(x_m, y_m, params):
    """Solve the sagittal linkage. Returns (theta_top_deg, theta_bot_deg) or None."""
    L1, L2 = params["L1"], params["L2"]
    origin = np.zeros(2)

    d = sqrt(x_m * x_m + y_m * y_m)
    max_reach = (L1 + L2) * 0.99
    if d > max_reach:
        x_m, y_m = x_m * max_reach / d, y_m * max_reach / d
        d = max_reach
    if d < abs(L1 - L2) * 1.01:
        return None

    cos_k = max(-1, min(1, (L1**2 + L2**2 - d**2) / (2 * L1 * L2)))
    knee_int = acos(cos_k)
    alpha = atan2(x_m, y_m)
    cos_b = max(-1, min(1, (L1**2 + d**2 - L2**2) / (2 * L1 * d)))
    theta_top = alpha - acos(cos_b)

    knee = np.array([L1 * sin(theta_top), L1 * cos(theta_top)])
    theta_lower = theta_top + (pi - knee_int)
    rod2_pt = knee - params["dko"] * np.array([sin(theta_lower), cos(theta_lower)])

    A, B = _ci(origin, params["rbl"], rod2_pt, params["Lr2"])
    if A is None:
        return None
    bc_left = A if A[0] <= B[0] else B
    phi_left = atan2(bc_left[0], bc_left[1])
    phi_right = phi_left - params["abc"]
    bc_right = np.array([params["rbr"] * sin(phi_right), params["rbr"] * cos(phi_right)])

    A, B = _ci(origin, params["rh"], bc_right, params["Lr1"])
    if A is None:
        return None
    horn = A if A[0] >= B[0] else B
    return degrees(theta_top), degrees(atan2(horn[0], horn[1]))


def sag_fk(theta_top_deg, theta_bot_deg, params):
    """Sagittal FK. Returns (x_mm, y_mm) or None."""
    theta_top = radians(theta_top_deg)
    theta_bot = radians(theta_bot_deg)
    L1, L2 = params["L1"], params["L2"]
    origin = np.zeros(2)

    knee = np.array([L1 * sin(theta_top), L1 * cos(theta_top)])
    horn = np.array([params["rh"] * sin(theta_bot), params["rh"] * cos(theta_bot)])
    A, B = _ci(origin, params["rbr"], horn, params["Lr1"])
    if A is None:
        return None

    def bcl_x(candidate):
        return sin(atan2(candidate[0], candidate[1]) + params["abc"])

    bc_right = A if bcl_x(A) < bcl_x(B) else B
    phi_right = atan2(bc_right[0], bc_right[1])
    phi_left = phi_right + params["abc"]
    bc_left = np.array([params["rbl"] * sin(phi_left), params["rbl"] * cos(phi_left)])
    A, B = _ci(knee, params["dko"], bc_left, params["Lr2"])
    if A is None:
        return None

    def diff(candidate):
        leg_dir = knee - candidate
        delta = (atan2(leg_dir[0], leg_dir[1]) - theta_top) % (2 * pi)
        return delta - 2 * pi if delta > pi else delta

    dA, dB = diff(A), diff(B)
    rod2 = A if 0 < dA < pi else (B if 0 < dB < pi else (A if abs(dA - pi / 2) < abs(dB - pi / 2) else B))
    leg_dir = (knee - rod2) / np.linalg.norm(knee - rod2)
    foot = knee + L2 * leg_dir
    return foot[0] * 1000, foot[1] * 1000


# ── Composite helpers ─────────────────────────────────────────────────────────

def full_ik_from_sag(x_mm, y_mm, lateral_m=None):
    """Full 3-DOF IK from a sagittal plane target in mm."""
    if lateral_m is None:
        lateral_m = LEG_SAGITTAL_OFFSET_M
    r_leg = np.array([x_mm / 1000.0, lateral_m, -y_mm / 1000.0], dtype=float)
    sol = leg_explicit_inverse_kinematics(r_leg, LEG_INDEX, _CONFIG)
    if sol is None:
        return None
    return tuple(np.degrees(sol))


def solve_body_target(bx, by, bz):
    """Full 3-DOF IK from a body-frame target in meters."""
    body_target = np.array([bx, by, bz], dtype=float)
    r_leg = body_target - _CONFIG.LEG_ORIGINS[:, LEG_INDEX]
    sol = leg_explicit_inverse_kinematics(r_leg, LEG_INDEX, _CONFIG)
    if sol is None:
        return None
    return tuple(np.degrees(sol))


def startup_reference_angles():
    """Return the raw zero-angle startup hold pose used while attaching the leg."""
    return servo_degrees_to_angles(*STARTUP_SERVO_DEG)


def _servo_deg_to_us(servo_deg):
    """Convert a direct servo angle in degrees into pulse width."""
    servo_deg = max(0.0, min(SERVO_RANGE_DEG, float(servo_deg)))
    return PWM_MIN_US + (servo_deg / SERVO_RANGE_DEG) * (PWM_MAX_US - PWM_MIN_US)


def _us_to_servo_deg(pulse_us):
    """Reverse of _servo_deg_to_us."""
    return (pulse_us - PWM_MIN_US) / (PWM_MAX_US - PWM_MIN_US) * SERVO_RANGE_DEG


def _servo_deg_to_ik(servo_deg, offset_deg, multiplier):
    """Convert a direct servo angle into the script's control-space angle."""
    servo_deg = max(0.0, min(SERVO_RANGE_DEG, float(servo_deg)))
    return (servo_deg - SERVO_CENTER_DEG - offset_deg) / multiplier


def servo_degrees_to_angles(hip_deg, top_deg, bot_deg):
    """Map direct servo angles into the script's control-space angle triplet."""
    return (
        _servo_deg_to_ik(hip_deg, HIP_OFFSET, HIP_MULTIPLIER),
        _servo_deg_to_ik(top_deg, TOP_OFFSET, TOP_MULTIPLIER),
        _servo_deg_to_ik(bot_deg, BOT_OFFSET, BOT_MULTIPLIER),
    )


def stand_reference_angles():
    """Return the neutral standing pose from the configured default stance."""
    body_target = _CONFIG.default_stance[:, LEG_INDEX] + np.array([0.0, 0.0, _CONFIG.default_z_ref])
    sol = solve_body_target(*body_target)
    if sol is None:
        raise RuntimeError(
            f"Neutral stand target {body_target} m is unreachable for leg {LEG_NAMES[LEG_INDEX]}"
        )
    return sol


def _ik_to_servo_deg(joint_angle_deg, offset_deg, multiplier):
    """Map an IK joint angle to a raw servo angle in degrees before pulse conversion."""
    return SERVO_CENTER_DEG + multiplier * joint_angle_deg + offset_deg


def _servo_limit_matrix_deg():
    """Return measured direct-servo limits, even when running against an older Config.py."""
    limits = getattr(_CONFIG, "SERVO_LIMITS_DEG", None)
    if limits is None:
        return FALLBACK_SERVO_LIMITS_DEG
    return np.asarray(limits, dtype=float)


def _coupled_bot_limits_servo_deg(top_servo_deg, margin_deg=0.0):
    """Return the measured bottom-servo window for a given top-servo angle."""
    config_fn = getattr(_CONFIG, "coupled_bot_limits_servo_deg", None)
    if callable(config_fn):
        return config_fn(top_servo_deg, margin_deg=margin_deg)

    servo_limits = _servo_limit_matrix_deg()
    top_lo, top_hi = servo_limits[1]
    bot_lo_hard, bot_hi_hard = servo_limits[2]
    clamped_top = float(np.clip(top_servo_deg, top_lo, top_hi))
    margin_deg = max(0.0, float(margin_deg))
    bot_min_samples = np.clip(
        FALLBACK_COUPLED_BOT_MIN_SAMPLES_DEG + margin_deg,
        bot_lo_hard,
        bot_hi_hard,
    )
    bot_max_samples = np.clip(
        FALLBACK_COUPLED_BOT_MAX_SAMPLES_DEG - margin_deg,
        bot_lo_hard,
        bot_hi_hard,
    )
    bot_min = float(np.interp(clamped_top, FALLBACK_COUPLED_TOP_SAMPLES_DEG, bot_min_samples))
    bot_max = float(np.interp(clamped_top, FALLBACK_COUPLED_TOP_SAMPLES_DEG, bot_max_samples))
    if bot_min > bot_max:
        midpoint = 0.5 * (bot_min + bot_max)
        bot_min = midpoint
        bot_max = midpoint
    return bot_min, bot_max


def _fallback_clamp_servo_triplet_deg(hip_deg, top_deg, bot_deg, coupled_margin_deg=0.0):
    """Clamp a direct servo command using only older Config.py primitives."""
    requested_hip = float(hip_deg)
    requested_top = float(top_deg)
    requested_bot = float(bot_deg)
    coupled_margin_deg = max(0.0, float(coupled_margin_deg))

    servo_limits = _servo_limit_matrix_deg()
    hip_lo, hip_hi = servo_limits[0]
    top_lo, top_hi = servo_limits[1]
    bot_lo_hard, bot_hi_hard = servo_limits[2]

    clamped_hip = float(np.clip(requested_hip, hip_lo, hip_hi))
    clamped_top = float(np.clip(requested_top, top_lo, top_hi))

    bot_lo, bot_hi = _coupled_bot_limits_servo_deg(
        clamped_top,
        margin_deg=coupled_margin_deg,
    )
    bot_lo = max(bot_lo_hard, float(bot_lo))
    bot_hi = min(bot_hi_hard, float(bot_hi))
    clamped_bot = float(np.clip(requested_bot, bot_lo, bot_hi))

    reasons = []
    if abs(clamped_hip - requested_hip) > 1e-9:
        reasons.append(
            f"hip {requested_hip:.1f}->{clamped_hip:.1f} deg "
            f"(safe range [{hip_lo:.1f}, {hip_hi:.1f}])"
        )
    if abs(clamped_top - requested_top) > 1e-9:
        reasons.append(
            f"top {requested_top:.1f}->{clamped_top:.1f} deg "
            f"(safe range [{top_lo:.1f}, {top_hi:.1f}])"
        )
    if abs(clamped_bot - requested_bot) > 1e-9:
        reasons.append(
            f"bot {requested_bot:.1f}->{clamped_bot:.1f} deg "
            f"(safe range [{bot_lo:.1f}, {bot_hi:.1f}] for top={clamped_top:.1f})"
        )

    return (clamped_hip, clamped_top, clamped_bot), bool(reasons), "; ".join(reasons)


def _clamp_safe_servo_triplet(hip_deg, top_deg, bot_deg, verbose=False):
    """Clamp a direct servo command to the measured envelope and optionally warn."""
    clamp_fn = getattr(_CONFIG, "clamp_servo_triplet_deg", None)
    if callable(clamp_fn):
        clamped_triplet, changed, reason = clamp_fn(
            float(hip_deg),
            float(top_deg),
            float(bot_deg),
            coupled_margin_deg=_CONFIG.BENCH_COUPLED_MARGIN_DEG,
        )
    else:
        clamped_triplet, changed, reason = _fallback_clamp_servo_triplet_deg(
            float(hip_deg),
            float(top_deg),
            float(bot_deg),
            coupled_margin_deg=getattr(_CONFIG, "BENCH_COUPLED_MARGIN_DEG", 0.0),
        )
    if changed and verbose:
        print(
            "  [WARN] Clamped servo target to measured limits: "
            f"hip={clamped_triplet[0]:.1f}  top={clamped_triplet[1]:.1f}  bot={clamped_triplet[2]:.1f}"
        )
        print(f"         {reason}")
    return clamped_triplet


def _ik_to_servo_us(joint_angle_deg, offset_deg, multiplier):
    """Map an IK joint angle to a servo pulse width in microseconds.

    Servos expect 0–180 degrees centered at SERVO_CENTER_DEG. Offset and multiplier
    correct for mounting direction and neutral position.
    """
    cmd = SERVO_CENTER_DEG + multiplier * joint_angle_deg + offset_deg
    return _servo_deg_to_us(cmd)


def _servo_us_to_ik(pulse_us, offset_deg, multiplier):
    """Reverse of _ik_to_servo_us: pulse width -> IK angle in degrees."""
    cmd = _us_to_servo_deg(pulse_us)
    return (cmd - SERVO_CENTER_DEG - offset_deg) / multiplier


def _us_to_duty(pulse_us):
    """Convert a pulse width in microseconds to a PCA9685 duty-cycle value (0–65535)."""
    period_us = 1_000_000.0 / PWM_FREQ
    return int(round(pulse_us / period_us * 65535))


def _duty_to_us(duty_16):
    """Reverse of _us_to_duty: 16-bit duty cycle -> pulse width in microseconds."""
    period_us = 1_000_000.0 / PWM_FREQ
    return duty_16 * period_us / 65535.0


_pca = None


def init_hardware():
    """Initialize the PCA9685. Returns True on success, False in sim mode."""
    global _pca
    try:
        import board
        import busio
        from adafruit_pca9685 import PCA9685

        i2c = busio.I2C(board.SCL, board.SDA)
        _pca = PCA9685(i2c, address=PCA9685_I2C_ADDRESS)
        _pca.frequency = PWM_FREQ
        print(
            f"  PCA9685 OK  (addr=0x{PCA9685_I2C_ADDRESS:02X}  "
            f"channels: hip={HIP_CH} top={TOP_CH} bot={BOT_CH})"
        )
        return True
    except Exception as exc:
        print(f"  [WARN] PCA9685 unavailable ({exc})")
        print("         Running in simulation mode.\n")
        return False


def _set_pulse(channel, pulse_us):
    if _pca is None:
        return
    _pca.channels[channel].duty_cycle = _us_to_duty(pulse_us)


def send_angles(t1_deg, tt_deg, tb_deg, verbose=True):
    """Drive all three servos to the given IK angles."""
    hip_deg = _ik_to_servo_deg(t1_deg, HIP_OFFSET, HIP_MULTIPLIER)
    top_deg = _ik_to_servo_deg(tt_deg, TOP_OFFSET, TOP_MULTIPLIER)
    bot_deg = _ik_to_servo_deg(tb_deg, BOT_OFFSET, BOT_MULTIPLIER)
    hip_deg, top_deg, bot_deg = _clamp_safe_servo_triplet(
        hip_deg,
        top_deg,
        bot_deg,
        verbose=verbose,
    )
    t1_cmd, tt_cmd, tb_cmd = servo_degrees_to_angles(hip_deg, top_deg, bot_deg)
    hip_us = _servo_deg_to_us(hip_deg)
    top_us = _servo_deg_to_us(top_deg)
    bot_us = _servo_deg_to_us(bot_deg)
    _set_pulse(HIP_CH, hip_us)
    _set_pulse(TOP_CH, top_us)
    _set_pulse(BOT_CH, bot_us)
    if verbose:
        print(f"    theta_1  ={t1_cmd:+7.2f} deg  ch{HIP_CH}  {hip_us:.0f} us")
        print(f"    theta_top={tt_cmd:+7.2f} deg  ch{TOP_CH}  {top_us:.0f} us")
        print(f"    theta_bot={tb_cmd:+7.2f} deg  ch{BOT_CH}  {bot_us:.0f} us")
    return t1_cmd, tt_cmd, tb_cmd


def move_to_angles(target_angles, from_angles=None, verbose=True):
    """Move to an angle triplet, interpolating when hardware is active."""
    t1_target, tt_target, tb_target = target_angles
    target_servo_deg = (
        _ik_to_servo_deg(t1_target, HIP_OFFSET, HIP_MULTIPLIER),
        _ik_to_servo_deg(tt_target, TOP_OFFSET, TOP_MULTIPLIER),
        _ik_to_servo_deg(tb_target, BOT_OFFSET, BOT_MULTIPLIER),
    )
    target_servo_deg = _clamp_safe_servo_triplet(*target_servo_deg, verbose=verbose)
    t1_target, tt_target, tb_target = servo_degrees_to_angles(*target_servo_deg)

    if from_angles is None or _pca is None:
        return send_angles(t1_target, tt_target, tb_target, verbose=verbose)

    t1_start, tt_start, tb_start = from_angles
    for step in range(1, STEPS_PER_MOVE + 1):
        blend = step / STEPS_PER_MOVE
        send_angles(
            t1_start + blend * (t1_target - t1_start),
            tt_start + blend * (tt_target - tt_start),
            tb_start + blend * (tb_target - tb_start),
            verbose=False,
        )
        time.sleep(STEP_DELAY_S)

    return send_angles(t1_target, tt_target, tb_target, verbose=verbose)


def move_to_servo_degrees(target_servo_deg, from_angles=None, verbose=True):
    """Move using direct servo angles in degrees."""
    hip_deg, top_deg, bot_deg = [float(v) for v in target_servo_deg]
    hip_deg, top_deg, bot_deg = _clamp_safe_servo_triplet(
        hip_deg,
        top_deg,
        bot_deg,
        verbose=verbose,
    )
    if verbose:
        print(
            f"\n  Servo target: hip={hip_deg:.1f} deg"
            f"  top={top_deg:.1f} deg  bot={bot_deg:.1f} deg"
        )
    return move_to_angles(
        servo_degrees_to_angles(hip_deg, top_deg, bot_deg),
        from_angles=from_angles,
        verbose=verbose,
    )


def move_to_sag(x_mm, y_mm, from_angles=None, verbose=True):
    """Move the foot to a sagittal target in mm."""
    sol = full_ik_from_sag(x_mm, y_mm)
    if sol is None:
        print(f"  [WARN] ({x_mm:.0f}, {y_mm:.0f}) mm unreachable - skipped")
        return None

    t1_deg, tt_deg, tb_deg = sol
    if verbose:
        fk = sag_fk(tt_deg, tb_deg, PARAMS)
        fk_str = f"({fk[0]:.1f}, {fk[1]:.1f})mm" if fk else "?"
        print(f"\n  Target: ({x_mm:.0f}, {y_mm:.0f})mm  FK check: {fk_str}")

    return move_to_angles((t1_deg, tt_deg, tb_deg), from_angles=from_angles, verbose=verbose)


def release():
    """Zero all servo duty cycles (lets the servos go limp)."""
    if _pca is None:
        return
    for channel in [HIP_CH, TOP_CH, BOT_CH]:
        _pca.channels[channel].duty_cycle = 0
    print("  Servos released.")


# ── Self-tests ────────────────────────────────────────────────────────────────

def test_math():
    """Run a quick smoke test around the configured neutral single-leg workspace."""

    print("\n-- IK/FK self-test ---------------------------------------------")
    print("  Neutral sagittal IK samples:")
    nominal_x_mm, nominal_y_mm = STARTUP_SAG
    sag_tests = [
        (nominal_x_mm, nominal_y_mm, "Neutral"),
        (nominal_x_mm + 12, nominal_y_mm, "Forward +12mm"),
        (nominal_x_mm - 20, nominal_y_mm, "Back -20mm"),
    ]
    print(f"  {'Pose':>16}   {'theta_1':>9}  {'theta_top':>10}  {'theta_bot':>10}")
    print("  " + "-" * 60)
    all_ok = True
    for x_mm, y_mm, name in sag_tests:
        sol = full_ik_from_sag(x_mm, y_mm)
        if sol is None:
            print(f"  {name:<16}  UNREACHABLE")
            all_ok = False
            continue
        t1, tt, tb = sol
        print(f"  {name:<16}   {t1:+8.3f}  {tt:+9.3f}  {tb:+9.3f}")

    print(f"\n  Neutral body-frame IK sample for leg {LEG_INDEX}:")
    stance = _CONFIG.default_stance + np.array([0.0, 0.0, _CONFIG.default_z_ref])[:, np.newaxis]
    body_target = stance[:, LEG_INDEX]
    body_tests = [
        (
            float(body_target[0]),
            float(body_target[1]),
            float(body_target[2]),
            f"Neutral, {LEG_NAMES[LEG_INDEX]}",
        ),
    ]
    print(f"  {'Pose':>18}   {'theta_1':>9}  {'theta_top':>10}  {'theta_bot':>10}")
    print("  " + "-" * 60)
    for bx, by, bz, name in body_tests:
        sol = solve_body_target(bx, by, bz)
        if sol is None:
            print(f"  {name:<18}  UNREACHABLE")
            all_ok = False
            continue
        print(f"  {name:<18}   {sol[0]:+8.3f}  {sol[1]:+9.3f}  {sol[2]:+9.3f}")

    print(f"\n  {'Smoke checks passed' if all_ok else 'Smoke checks failed'}")
    return all_ok


def test_sweep(sim_only=False):
    """Sweep the foot through an arc of waypoints and check each IK solution."""
    from math import sqrt

    print("\n-- Sweep test --------------------------------------------------")
    nominal_y_mm = STARTUP_SAG[1]
    waypoints = [
        (0, nominal_y_mm),
        (20, nominal_y_mm - 5),
        (40, nominal_y_mm - 10),
        (40, nominal_y_mm),
        (20, nominal_y_mm + 10),
        (0, nominal_y_mm + 10),
        (-20, nominal_y_mm + 10),
        (-40, nominal_y_mm),
        (-40, nominal_y_mm - 10),
        (-20, nominal_y_mm - 5),
        (0, nominal_y_mm),
    ]
    current = None
    if not sim_only and _pca is not None:
        print("  Moving to start ...")
        current = move_to_sag(*waypoints[0], verbose=True)
        time.sleep(0.5)

    print(f"\n  {'Step':>4}  {'x':>6}  {'y':>6}  {'theta_1':>9}  {'theta_top':>10}  {'theta_bot':>10}  FK err")
    print("  " + "-" * 78)
    for i, (x, y) in enumerate(waypoints):
        sol = full_ik_from_sag(x, y)
        if sol is None:
            print(f"  {i + 1:>4}  ({x:+4.0f},{y:4.0f})  UNREACHABLE")
            continue
        t1, tt, tb = sol
        fk = sag_fk(tt, tb, PARAMS)
        r_foot = np.array([x / 1000.0, LEG_SAGITTAL_OFFSET_M, -y / 1000.0])
        _, xs, ys = hip_ik(r_foot, LEG_INDEX, PARAMS)
        err = sqrt((fk[0] - xs * 1000) ** 2 + (fk[1] - ys * 1000) ** 2) if fk else float("nan")
        ok = "OK" if err < 0.001 else f"{err:.3f} mm"
        print(
            f"  {i + 1:>4}  ({x:+4.0f},{y:4.0f})  {t1:+8.2f} deg"
            f"  {tt:+9.2f} deg  {tb:+9.2f} deg  {ok}"
        )
        if not sim_only and _pca is not None:
            current = move_to_sag(x, y, from_angles=current, verbose=False)
            time.sleep(0.3)

    if not sim_only and _pca is not None:
        print("\n  Sweep done. Releasing in 2 s ...")
        time.sleep(2)
        release()


def test_mock_walk(sim_only=False, cycles=2, from_angles=None):
    """Run a small direct-servo stepping pattern around the standing pose."""
    cycles = max(1, int(cycles))
    print("\n-- Mock walk ---------------------------------------------------")
    current = from_angles
    step = 1

    if current is None:
        current = startup_reference_angles()

    for cycle in range(cycles):
        print(f"  Cycle {cycle + 1}/{cycles}")
        for servo_target in MOCK_WALK_SERVO_WAYPOINTS:
            hip_deg, top_deg, bot_deg = servo_target
            target_angles = servo_degrees_to_angles(*servo_target)
            print(
                f"    step {step:>2}: servo=({hip_deg:5.1f}, {top_deg:5.1f}, {bot_deg:5.1f}) deg"
                f"  cmd=({target_angles[0]:+6.1f}, {target_angles[1]:+6.1f}, {target_angles[2]:+6.1f})"
            )
            if not sim_only and _pca is not None:
                current = move_to_servo_degrees(
                    servo_target,
                    from_angles=current,
                    verbose=False,
                )
                time.sleep(MOCK_WALK_DWELL_S)
            else:
                current = target_angles
            step += 1

    if not sim_only and _pca is not None:
        current = move_to_servo_degrees(
            STARTUP_SERVO_DEG,
            from_angles=current,
            verbose=False,
        )
        print("\n  Mock walk done. Standing at startup pose.")

    return current


def interactive(sim_only=False):
    global HIP_OFFSET, TOP_OFFSET, BOT_OFFSET
    print("\n-- Interactive mode -------------------------------------------")
    startup = startup_reference_angles()
    stand = stand_reference_angles()
    hip_us = _servo_deg_to_us(STARTUP_SERVO_DEG[0])
    top_us = _servo_deg_to_us(STARTUP_SERVO_DEG[1])
    bot_us = _servo_deg_to_us(STARTUP_SERVO_DEG[2])

    print("  Servos are PASSIVE (no PWM). Position the leg at the startup")
    print("  assembly pose below, then type 'hold' to lock that reference.")
    print()
    print("  Startup assembly servo angles and pulse widths:")
    print(
        f"    hip  (ch{HIP_CH}): {STARTUP_SERVO_DEG[0]:6.1f} deg  ->  {hip_us:.0f} us"
    )
    print(
        f"    top  (ch{TOP_CH}): {STARTUP_SERVO_DEG[1]:6.1f} deg  ->  {top_us:.0f} us"
    )
    print(
        f"    bot  (ch{BOT_CH}): {STARTUP_SERVO_DEG[2]:6.1f} deg  ->  {bot_us:.0f} us"
    )
    print("  Equivalent startup control-space angles:")
    print(
        f"    theta_1={startup[0]:+7.2f}  "
        f"theta_top={startup[1]:+7.2f}  theta_bot={startup[2]:+7.2f}"
    )
    print("  Neutral stand control-space target:")
    print(
        f"    theta_1={stand[0]:+7.2f}  "
        f"theta_top={stand[1]:+7.2f}  theta_bot={stand[2]:+7.2f}"
    )
    print()
    print("  If 'hold' causes a servo to jump the wrong way:")
    print("    - flip its MULTIPLIER to -1 in the code")
    print("  If a servo is off by a few degrees:")
    print("    - use 'offset hip|top|bot <deg>' to adjust live")
    print("    - use 'show_offsets' to print values to hard-code")

    current = None  # No position locked yet.

    print("\n  Commands:")
    print("    hold                 lock servos at startup assembly pose (first command!)")
    print("    servo <h> <t> <b>    move by direct servo angles in degrees")
    print("    raw <t1> <tt> <tb>   move by control-space angles")
    print("    sag <x> <y>         sagittal target in mm")
    print("    body <x> <y> <z>    body-frame target in meters")
    print("    offset <hip|top|bot> <deg>   adjust offset & re-send")
    print("    show_offsets         print current offsets for code")
    print("    ik <x> <y>          print IK only")
    print("    fk <tt> <tb>        print FK only")
    print("    sweep                run the arc sweep")
    print("    mockwalk [n]         run the direct-servo mock walk for n cycles")
    print("    stand / neutral      move to the configured neutral stand pose")
    print("    release              let the servos go limp")
    print("    q / quit             exit")
    print()

    while True:
        try:
            raw = input("  > ").strip()
        except (KeyboardInterrupt, EOFError):
            break

        if not raw:
            continue

        parts = raw.split()
        cmd = parts[0].lower()

        if cmd in ("q", "quit", "exit"):
            break

        if cmd == "sag" and len(parts) == 3:
            try:
                x_mm, y_mm = float(parts[1]), float(parts[2])
                current = move_to_sag(x_mm, y_mm, from_angles=current, verbose=True)
            except ValueError as exc:
                if str(exc).startswith("could not convert string"):
                    print("  Usage: sag <x_mm> <y_mm>")
                else:
                    print(f"  [WARN] {exc}")
            continue

        if cmd == "body" and len(parts) == 4:
            try:
                bx, by, bz = float(parts[1]), float(parts[2]), float(parts[3])
                sol = solve_body_target(bx, by, bz)
                if sol is None:
                    print("  Unreachable")
                    continue
                t1_deg, tt_deg, tb_deg = sol
                print(
                    f"  IK: theta_1={t1_deg:+.2f} deg"
                    f"  theta_top={tt_deg:+.2f} deg  theta_bot={tb_deg:+.2f} deg"
                )
                current = move_to_angles(
                    (t1_deg, tt_deg, tb_deg), from_angles=current, verbose=True
                )
            except ValueError as exc:
                if str(exc).startswith("could not convert string"):
                    print("  Usage: body <x_m> <y_m> <z_m>")
                else:
                    print(f"  [WARN] {exc}")
            continue

        if cmd == "raw" and len(parts) == 4:
            try:
                t1_deg, tt_deg, tb_deg = float(parts[1]), float(parts[2]), float(parts[3])
                current = move_to_angles(
                    (t1_deg, tt_deg, tb_deg), from_angles=current, verbose=True
                )
                fk = sag_fk(tt_deg, tb_deg, PARAMS)
                if fk:
                    print(f"  FK foot (sagittal): ({fk[0]:.2f}, {fk[1]:.2f}) mm")
            except ValueError as exc:
                if str(exc).startswith("could not convert string"):
                    print("  Usage: raw <t1_deg> <tt_deg> <tb_deg>")
                else:
                    print(f"  [WARN] {exc}")
            continue

        if cmd == "servo" and len(parts) == 4:
            try:
                hip_deg, top_deg, bot_deg = (
                    float(parts[1]),
                    float(parts[2]),
                    float(parts[3]),
                )
                current = move_to_servo_degrees(
                    (hip_deg, top_deg, bot_deg),
                    from_angles=current,
                    verbose=True,
                )
            except ValueError as exc:
                if str(exc).startswith("could not convert string"):
                    print("  Usage: servo <hip_deg> <top_deg> <bot_deg>")
                else:
                    print(f"  [WARN] {exc}")
            continue

        if cmd == "offset" and len(parts) == 3:
            try:
                which = parts[1].lower()
                val = float(parts[2])
                if which == "hip":
                    HIP_OFFSET = val
                elif which == "top":
                    TOP_OFFSET = val
                elif which == "bot":
                    BOT_OFFSET = val
                else:
                    print("  Usage: offset <hip|top|bot> <deg>")
                    continue
                print(f"  {which.upper()}_OFFSET = {val:+.1f} deg")
                # Re-send current position with new offset.
                if current is not None:
                    send_angles(*current, verbose=True)
                    print("  Re-sent current angles with updated offset.")
            except ValueError as exc:
                if str(exc).startswith("could not convert string"):
                    print("  Usage: offset <hip|top|bot> <deg>")
                else:
                    print(f"  [WARN] {exc}")
            continue

        if cmd == "show_offsets":
            print(f"\n  Copy these into the script header:")
            print(f"    HIP_OFFSET = {HIP_OFFSET}")
            print(f"    TOP_OFFSET = {TOP_OFFSET}")
            print(f"    BOT_OFFSET = {BOT_OFFSET}")
            print()
            continue

        if cmd == "ik" and len(parts) == 3:
            try:
                x_mm, y_mm = float(parts[1]), float(parts[2])
                sol = full_ik_from_sag(x_mm, y_mm)
                if sol is None:
                    print(f"  ({x_mm}, {y_mm}) mm unreachable")
                    continue
                t1_deg, tt_deg, tb_deg = sol
                fk = sag_fk(tt_deg, tb_deg, PARAMS)
                print(
                    f"  IK: theta_1={t1_deg:+.2f} deg"
                    f"  theta_top={tt_deg:+.2f} deg  theta_bot={tb_deg:+.2f} deg"
                )
                if fk:
                    from math import sqrt
                    err = sqrt((fk[0] - x_mm) ** 2 + (fk[1] - y_mm) ** 2)
                    print(f"  FK check: ({fk[0]:.4f}, {fk[1]:.4f})mm  err={err:.6f}mm")
            except ValueError:
                print("  Usage: ik <x_mm> <y_mm>")
            continue

        if cmd == "fk" and len(parts) == 3:
            try:
                tt_deg, tb_deg = float(parts[1]), float(parts[2])
                fk = sag_fk(tt_deg, tb_deg, PARAMS)
                if fk:
                    print(
                        f"  FK: theta_top={tt_deg:.2f} deg"
                        f"  theta_bot={tb_deg:.2f} deg  ->  ({fk[0]:.2f}, {fk[1]:.2f})mm"
                    )
                else:
                    print("  FK: infeasible")
            except ValueError:
                print("  Usage: fk <theta_top_deg> <theta_bot_deg>")
            continue

        if cmd == "sweep":
            test_sweep(sim_only=sim_only)
            current = None
            continue

        if cmd == "mockwalk":
            try:
                cycles = 2 if len(parts) == 1 else int(parts[1])
                current = test_mock_walk(
                    sim_only=sim_only,
                    cycles=cycles,
                    from_angles=current,
                )
            except ValueError:
                print("  Usage: mockwalk [cycles]")
            continue

        if cmd in ("neutral", "stand"):
            current = move_to_angles(
                stand,
                from_angles=current,
                verbose=True,
            )
            continue

        if cmd == "hold":
            if current is None:
                # First hold — send the startup assembly pose to lock servos.
                current = startup_reference_angles()
            send_angles(*current, verbose=True)
            print("  Servos locked.")
            continue

        if cmd == "release":
            release()
            current = None
            continue

        print(f"  Unknown: {raw}")

    if not sim_only and _pca is not None:
        print("\n  Releasing ...")
        release()


# ── Entry point ───────────────────────────────────────────────────────────────

def main():
    parser = argparse.ArgumentParser(description="Argos 3-DOF single-leg test")
    parser.add_argument("--sim", action="store_true", help="Simulation only (no I2C)")
    parser.add_argument("--math", action="store_true", help="Run the IK/FK self-test and exit")
    parser.add_argument("--sweep", action="store_true", help="Run the arc sweep and exit")
    parser.add_argument(
        "--sag", nargs=2, type=float, metavar=("X", "Y"),
        help="Move foot to sagittal (X Y) mm and exit",
    )
    parser.add_argument(
        "--goto", nargs=3, type=float, metavar=("X", "Y", "Z"),
        help="Move foot to body-frame (X Y Z) m and exit",
    )
    parser.add_argument(
        "--raw", nargs=3, type=float, metavar=("T1", "TT", "TB"),
        help="Send raw angles (theta_1 theta_top theta_bot in degrees) and exit",
    )
    parser.add_argument(
        "--servo",
        nargs=3,
        type=float,
        metavar=("HIP", "TOP", "BOT"),
        help="Send direct servo angles in degrees and exit",
    )
    parser.add_argument(
        "--mock-walk",
        nargs="?",
        const=2,
        type=int,
        metavar="CYCLES",
        help="Run the direct-servo mock walk routine and exit",
    )
    args = parser.parse_args()

    leg_name = LEG_NAMES[LEG_INDEX]
    startup_t1_deg, startup_tt_deg, startup_tb_deg = startup_reference_angles()
    stand_t1_deg, stand_tt_deg, stand_tb_deg = stand_reference_angles()

    print("=" * 62)
    print("  Argos 3-DOF Single-Leg Test")
    print(f"  Leg index   : {LEG_INDEX} ({leg_name})")
    print(f"  Channels    : hip={HIP_CH}  top={TOP_CH}  bot={BOT_CH}")
    print(f"  Servo travel: {SERVO_RANGE_DEG:.0f} deg  center={SERVO_CENTER_DEG:.1f} deg")
    print(
        "  Startup assembly servo: "
        f"hip={STARTUP_SERVO_DEG[0]:.1f}  top={STARTUP_SERVO_DEG[1]:.1f}  bot={STARTUP_SERVO_DEG[2]:.1f}"
    )
    print(
        "  Startup hold cmd  : "
        f"theta_1={startup_t1_deg:+.2f}  "
        f"theta_top={startup_tt_deg:+.2f}  "
        f"theta_bot={startup_tb_deg:+.2f}"
    )
    print(f"  Startup sag : ({STARTUP_SAG[0]}, {STARTUP_SAG[1]}) mm")
    print(
        "  Neutral stand cmd : "
        f"theta_1={stand_t1_deg:+.2f}  "
        f"theta_top={stand_tt_deg:+.2f}  "
        f"theta_bot={stand_tb_deg:+.2f}"
    )
    print(
        f"  L1_hip={PARAMS['L1_hip'] * 1000:.1f}mm"
        f"  L_upper={PARAMS['L1'] * 1000:.1f}mm"
        f"  L_lower={PARAMS['L2'] * 1000:.1f}mm"
    )
    print(
        f"  BC left={PARAMS['rbl'] * 1000:.1f}mm"
        f"  right={PARAMS['rbr'] * 1000:.1f}mm"
        f"  alpha={degrees(PARAMS['abc']):.0f} deg"
    )
    print(
        f"  Rod1={PARAMS['Lr1'] * 1000:.1f}mm"
        f"  Rod2={PARAMS['Lr2'] * 1000:.1f}mm"
        f"  horn={PARAMS['rh'] * 1000:.1f}mm"
        f"  dko={PARAMS['dko'] * 1000:.1f}mm"
    )
    print("=" * 62)

    if not test_math():
        print("\n  IK self-test failed. Check PARAMS before moving hardware.")
        sys.exit(1)

    if args.math:
        return

    sim_only = args.sim
    if not sim_only:
        sim_only = not init_hardware()

    if args.sag:
        x_mm, y_mm = args.sag
        print(f"\n  Moving to sagittal ({x_mm:.0f}, {y_mm:.0f}) mm ...")
        move_to_sag(x_mm, y_mm, verbose=True)
        if not sim_only:
            time.sleep(2)
            release()
        return

    if args.goto:
        bx, by, bz = args.goto
        sol = solve_body_target(bx, by, bz)
        if sol is None:
            print("  Unreachable")
            return
        t1_deg, tt_deg, tb_deg = sol
        print(
            f"  Body ({bx:.3f}, {by:.3f}, {bz:.3f})m ->"
            f"  theta_1={t1_deg:+.2f} deg  theta_top={tt_deg:+.2f} deg  theta_bot={tb_deg:+.2f} deg"
        )
        move_to_angles((t1_deg, tt_deg, tb_deg), verbose=True)
        if not sim_only:
            time.sleep(2)
            release()
        return

    if args.raw:
        t1_deg, tt_deg, tb_deg = args.raw
        move_to_angles((t1_deg, tt_deg, tb_deg), verbose=True)
        if not sim_only:
            time.sleep(2)
            release()
        return

    if args.servo:
        hip_deg, top_deg, bot_deg = args.servo
        move_to_servo_degrees((hip_deg, top_deg, bot_deg), verbose=True)
        if not sim_only:
            time.sleep(2)
            release()
        return

    if args.sweep:
        test_sweep(sim_only=sim_only)
        return

    if args.mock_walk is not None:
        test_mock_walk(sim_only=sim_only, cycles=args.mock_walk)
        if not sim_only:
            time.sleep(2)
            release()
        return

    interactive(sim_only=sim_only)


if __name__ == "__main__":
    main()
