The-Faulty/Argos/(commit log)

2026-04-01 Add Argos 3-DOF single-leg test and utility functions
    - Implemented single-leg test script (single_leg_test.py) for controlling a 3-DOF leg using PCA9685 over I2C.
    - Added utility functions in util.py for converting Cartesian coordinates to polar angles and generating 3D rotation matrices.
    - Created a new ROS2 package (quadruped_bringup) with launch files for RealSense camera and RPLidar integration.
    - Included configuration and launch files for the quadruped robot, enabling visualization in RViz.
    - Added placeholder files for future configuration and ensured proper package structure.
2026-04-09 Add Argos control package and safety node implementation
    - Created a new ROS 2 package `argos_control` with essential dependencies.
    - Implemented `safety_node.py` for safety filtering of joint commands.
    - Added configuration files for control stack and robot description.
    - Developed launch files for the control stack, sensors, and visualization in RViz.
    - Included udev rules for device management on Raspberry Pi.
    - Established a comprehensive URDF model for the Argos quadruped robot.
    [quadruped.urdf.xacro]
2026-04-13 Add Argos mission and perception nodes
    - Introduced `argos_mission` package containing nodes for gas mapping, thermal imaging, and victim detection.
    - Implemented `GasMappingNode` to project gas sensor readings into a 2D hazard occupancy grid.
    - Created `ThermalNode` to publish mock thermal images for testing.
    - Developed `VictimDetectorNode` to detect thermal hotspots and publish RViz markers for potential victims.
    - Added `MissionOrchestratorNode` to manage mission states and control gait modes based on state transitions.
    - Defined shared topic names and mission states in `mission_contract.py`.
    - Configured parameters for each node in `mission_stack.yaml`.
    - Created launch files to facilit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
2026-04-14 Add foothold checker node and related configurations
    - Updated package.xml to include dependencies for tf2_ros and visualization_msgs.
    - Added foothold_checker_node to setup.py for execution.
    - Enhanced control_stack.yaml with parameters for foothold checking.
    - Integrated foothold_checker_node into control stack launch file.
    - Modified view_camera.launch.py to prefer camera-specific RViz config.
    - Updated quadruped URDF model with new leg dimensions.
    - Created .gitattributes for consistent line endings.
    - Implemented foothold_checker_node with depth image processing and foothold evaluation logic.
    - Added servo_test.py for testing servo angles using PCA9685.
    [quadruped.urdf.xacro]
2026-04-14 Code review fixes: remove dead code, fix bugs, refactor duplication, add tests
    - Delete Controller.py (legacy ROS 1 / rospy dead code)
    - Fix gait_planner: tick counter now only resets when entering a walking
    gait from a static pose (stand/crouch); walking↔walking switches leave
    ticks running so mid-swing legs don't freeze or jump
    - Refactor single_leg_test.py: remove ~90 lines of duplicated IK/FK math
    and geometry constants; now imports from Kinematics.py and Config.py so
    hardware changes only need to be made in one place
    - Upgrade mission_contract.py MISSION_STATES tuple to MissionState(str,Enum)
    for type safety; update mission_orchestrator_node.py to use it
    - Add pytest suite (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
    [Kinematics.py, command_mux_node.py, control_core.py, gait_planner_node.py, joint_command_publisher_node.py]
2026-04-14 Add student-style comments to Config.py and Kinematics.py
2026-04-15 Add expo demo stack, command odometry, and demo commander nodes
2026-04-16 Enhance thermal detection and kinematics functionality
    - Updated mission_stack.yaml to improve thermal_node configuration with additional parameters for better simulation and real sensor integration.
    - Added new tests for joint limits and inverse kinematics in test_kinematics.py to ensure compliance with measured data.
    - Introduced Lidar SLAM setup guide as a new PDF document for user reference.
    - Created limit_finder.py to assist in exploring joint limits for the Argos robot, allowing for safe servo adjustments.
    - Developed thermal_common.py and thermal_detection.py to provide shared utilities for thermal camera processing and detection algorithms.
    - Implemented unit tests for thermal detec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
2026-04-16 Add single-leg web visualization
    Standalone 3D page under web/leg_viz/ that mirrors the bench test in
    single_leg_test.py. Ports the sagittal FK from Kinematics.py to JS so
    the bell-crank linkage renders exactly; servo 90/90/90 is calibrated
    to the default stand pose. Presets: Stand, Crouch, Stretch, Walk, Trot.
2026-04-16 Add Pi HTTP bridge so leg viz can drive real servos
    server.py is a stdlib-only server that hosts the viz and exposes
    /api/servo + /api/release, writing directly to the PCA9685 with the
    same channel map and PWM limits as single_leg_test.py. The page gains
    a 'Drive robot' toggle that throttles POSTs to 20 Hz and only sends
    when the pose changes, so gait animations don't flood the server.
2026-04-16 Vendor Three.js and fix TDZ bug so the viz runs on the Pi hotspot
    The Pi's Windows-ICS hotspot has no internet access, so the importmap
    couldn't reach unpkg.com -- viz.js failed to resolve the "three"
    specifier and never ran its module body. Vendor three.module.js and
    OrbitControls.js under web/leg_viz/vendor/three/ and point the importmap
    at them so the page works fully offline.
    Also fix a temporal-dead-zone bug where resizeRenderer() ran at module
    top level before the const-declared camera was initialized, throwing
    "Cannot access 'camera' before initialization". The first tick() already
    calls resizeRenderer(), so the early call was redundant.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
2026-04-16 Fix Walk/Trot gait so the foot actually strides forward
    The old gait fed the fore/aft sweep into both top and bot at similar
    magnitudes, so horizontal foot motion largely cancelled out and only
    the vertical lift was visible. Rewrite so the fore/aft sweep comes
    purely from theta_top (upper leg pivoting about the hip) and the lift
    comes purely from theta_bot (bell-crank retracting the knee during
    swing). Phase layout: swing in ph [0, 0.5] (foot lifted, rear→forward),
    stance in ph [0.5, 1] (foot planted, forward→rear propulsion).
    Verified in the browser preview: over one 1.6 s walk cycle the foot
    sagittal position sweeps from roughly (-12, 122) mm (mid-swing, lifted
    rear) through (+25, 140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
2026-04-16 Reverse bot servo, offset bell-crank pivot, smooth transitions, fix Release
    Kinematics corrections:
    - MULTIPLIERS.bot flipped from +1 to -1: the physical bottom servo is
    mounted reversed from the top one, so a servo increase drives
    control-space theta_bot DOWN, not up.
    - New LEG_PARAMS.botPivotX / botPivotY: the horn rotates about the bot
    servo shaft which sits 20 mm behind (-x) and 20 mm below (+y) the
    top servo -- the FK used to assume they were coaxial.
    - OFFSETS re-solved numerically against the updated FK so servo
    90/90/90 still lands the foot at (0, 165 mm) sagittal (stand pose).
    New offsets: top=+49.565 deg, bot=+53.503 deg.
    - PRESET_CROUCH / PRESET_STRETCH servo values re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
2026-04-17 Revert bot-pivot calibration; restore single_leg_test.py defaults
    The previous session baked a non-zero bot-servo pivot offset and
    non-zero OFFSETS into kinematics.js, on the theory that servo 90/90/90
    needed a numeric correction to land the foot in the stand pose. Bench
    testing showed single_leg_test.py drives the leg correctly with all
    multipliers/offsets at their documented defaults, so the calibration
    overreach was actually wrong.
    - kinematics.js: drop botPivotX/botPivotY, revert sagittalFkState horn
    to rotate about the origin, restore MULTIPLIERS = {hip:-1, top:+1,
    bot:+1} and OFFSETS = all zeros. Widen theta_top upper limit from
    +10 to +30 to accommodate the 90/115/90 crouch pre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
2026-04-17 Add URDF mesh viewer with physical robot bridge
    Self-contained HTML page that renders the quadruped from baked-in CAD
    meshes (base64+gzip STL geometry inline), walks the URDF joint tree
    with the same ported bell-crank kinematics as viz.js, and drives all
    four legs through a trot gait. Ships alongside the existing cylinder
    viz (index.html) so neither page can regress the other.
    Robot-drive layer (same /api/servo contract as server.py uses for the
    cylinder viz): a Drive toggle and Release button in the sidebar stream
    the active leg's angles at 50 Hz when the pose changes by >=0.1 deg.
    Release turns the drive flag off first so the 50 Hz poster can't
    immediately re-power the servos.
    Calibratio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
2026-04-17 Restore URDF viewer's original Stand pose; use delta-from-stand mapping
    The previous commit changed the viewer's Stand preset to (top=0, bot=0)
    so it would send 90/90/90 to the robot under a literal servo = 90 - value
    rule. That collapsed the 3D visual stand pose to the URDF zero pose,
    which was not the intent — the user's reference is the original HTML's
    stand (top=-55.5, bot=+55.5), which is where the real servos read
    90/90/90.
    Restore the original Stand pose everywhere (preset, LA[] init, slider
    defaults, Stop button reset) and rewrite the servo mapping to subtract
    the DELTA from stand from 90:
    servo = 90 - (currentAngleDeg - standAngleDeg)
    That preserves the original visual at S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
2026-04-17 Reparameterize URDF viewer sliders to signed servo-delta from 90
    The sliders previously displayed raw URDF joint angles, so the Stand
    pose read -55.5°/+55.5° on the Top/Bot sliders even though the servos
    there are 90/90/90. The sliders now represent the signed delta from 90
    on each channel, so Stand reads 0/0/0 and a +N° drag produces servo
    90+N. Internal state (LA[]) still stores URDF radians; the 3D render
    and the laToServo() mapping are untouched.
2026-04-17 Enforce Config.py joint limits in URDF viewer sliders
    Applies the control-space per-axis limits from Config.JOINT_LIMITS_DEG
    to the slider min/max (hip unchanged ±45, top -40..+25, bot -85..+90),
    and adds runtime enforcement of the coupled top/bot envelope from
    Config.COUPLED_*_SAMPLES_DEG so moving the top slider automatically
    clamps bot to the bench-validated safe range.
    Crouch preset was clipped from top=-90° (slider +34.5, outside limits)
    to top=-80.5° (slider +25, top-servo hard stop, inside envelope).
2026-04-17 Add Home button + reverse servo direction for back legs
    Two UX additions to the URDF viewer:
    1. Home button next to Release in the Robot panel. Turns off Drive,
    parks LA at Stand, then POSTs /api/home which re-runs server.py's
    existing home_servos() wake-up sweep (90 -> 45 -> 90). Useful when
    the PCA9685 latches a leftover duty cycle from a previous run and
    a servo won't respond to a static setpoint.
    2. Per-leg servo direction. Back legs (RR=2, RL=3) are mounted mirrored
    on the body, so laToServo flips the sign for them (servo = 90 + delta
    instead of 90 - delta). The coupled top/bot safe envelope and the
    per-axis slider min/max are mirrored accordingly (COUPLED_*_B arr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
2026-04-17 Mirror only the hip servo on back legs
    The previous commit flipped the sign on all three channels (hip, top,
    bot) for the back legs. On the physical RL leg that produced wrong
    degrees on top and bot because those servos are mounted on the same
    side of the leg regardless of front/back — only the hip axis is
    mirrored across the body's long axis. Reverting top/bot to the
    front-leg calibration fixes the rear-leg pose on the real robot.
    - LEG_SERVO_SIGN → LEG_HIP_SIGN; only laToServo()'s hip line consults it.
    - Remove the back-leg coupled-envelope variants and back-leg slider
    limits; top/bot are uniform across all four legs now, so the
    front-leg envelope and the static HTML slider min/ma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
2026-04-17 Fix SERVO_RANGE_DEG in leg_viz server (270 -> 180)
    The HTTP bridge was computing pulse widths assuming 270-deg servos, but
    the physical servos are 180-deg (per servo_test.py and single_leg_test.py,
    both of which work correctly). The mismatch meant every angle the browser
    sent was compressed into the lower 2/3 of the servo's real travel:
    viewer servo=90 (true center)
    before: 370 + (90/270)*(2400-370) = 1047 us (~60 deg actual)
    after: 370 + (90/180)*(2400-370) = 1385 us (true center)
    Which is why the bench test lined up but the viewer didn't — the
    viewer's angles were correct, they were just being mapped to the wrong
    pulse widths on the way out.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
2026-04-17 Slew-limited quaternion SLERP tween for servo commands
    Previously every 50 Hz tick posted LA[aL] directly, so a preset press
    or leg-switch fired a full 25°+ delta at the servo in one refresh and
    made the bench clack. Now we track the last pose actually commanded
    (ROBOT.cur) and each tick advance it toward the target by at most
    ROBOT.maxDegPerSec * dt (≈4.8° at 240 °/s and 20 ms), SLERPing through
    THREE.Quaternion.
    For scalar-axis joints SLERP of axis-angle quats about one axis
    reduces exactly to linear angle interp; the quaternion routing is
    kept so the tween reads as a rotation-space operation and so this can
    later be swapped for true 3D pose blending without restructuring.
    Drive-on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
2026-04-17 Add global Move-speed slider for servo slew rate
    Adds a slider in the Robot section that drives ROBOT.maxDegPerSec
    directly, so you can dial overall movement smoothness/snappiness
    without touching code. Range 30–1500 °/s, step 10, default 400.
    - 30 °/s — very buttery, a full 180° sweep takes 6 s (demo-mode)
    - 400 °/s — default, presets ramp in ~60 ms, sliders feel instant
    - 1500 °/s — higher than any hobby servo can mechanically track,
    so the slew cap is effectively off
    The existing "Speed" slider under Gait remains gait-cycle-only;
    this new slider is independent and always in effect (sliders,
    presets, gait, leg-switch all pass through it).
    Also bumps defa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
2026-04-17 Rework servo tween: N-step SLERP + chained posts, add Steps slider
    Two real fixes plus the new slider:
    1. Bug: driveServoTween still referenced ROBOT.lastPostMs after I'd
    renamed it to lastTickMs on the state object, so dt was computed
    against undefined and clamped to 0.1 s every tick, and the
    20 ms-period guard was comparing against undefined too. This
    explains "doesn't go to correct positions anymore" — the tween
    was effectively running with random dt. Now uses lastTickMs
    consistently everywhere.
    2. POST was throttled by the tween, not the other way around. If a
    POST took 30 ms to complete, all 50 Hz ticks during that window
    were dropped. Now the tween advances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
2026-04-19 Wire ESP32-C6 firmware to micro-ROS contract; add build guide
    The ESP32-C6 now subscribes to /joint_command and drives the PCA9685
    directly, echoes /joint_states at 100 Hz, publishes IMU at 100 Hz and a
    filtered MQ-series gas reading on /gas at 10 Hz, and limps all 12 servos
    if /joint_command stops for more than 250 ms. This matches the topic
    contract that the Pi side already implements, removes the Pi-side
    preview /joint_states publisher, and unblocks the expo demo path where
    the Pi owns perception (LiDAR + RealSense + SLAM) and the C6 owns the
    fast control loop.
    Also adds docs/build_guide.md (end-to-end build/flash/bring-up), updates
    expo_master_todo.md with firmware/wiring/Pi-verificatio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
2026-04-19 Set PCA9685 default address to 0x00 to match Argos board
    Default was 0x40 (stock Adafruit-style breakout). The Argos PCA9685 is
    wired to respond at 0x00. Updated the Kconfig default, the main.c
    fallback, the driver's static initializer, and the build guide so the
    out-of-the-box build talks to the right address.
2026-04-19 Refactor quadruped bringup and Argos description integration
    - Added materials.xacro for Argos robot materials.
    - Enhanced realsense.launch.py to include static transform publisher for camera mount.
    - Updated rplidar.launch.py to publish static TF for lidar frame.
    - Modified sensors.launch.py to include static TF for lidar.
    - Changed state_publisher.launch.py to use Argos URDF and added base_footprint transform.
    - Updated view_camera.launch.py to reference Argos description package.
    - Updated package.xml to replace quadruped_description dependency with Argos_description.
    [Argos.xacro, FL_150mm_linkage_1.stl, FL_30mm_linkage_1.stl, FL_coxa_link_1.stl, FL_femur_link_1.stl, FL_shoulder_link_1.stl, FL_tibia_link_1.stl, FR_150mm_linkage_1.stl]
2026-04-22 Switch to final robot model and add bringup tooling
    [Argos.xacro, chassis_top_front_1.stl, lidar_link_1.stl, quadruped.urdf.xacro]
2026-04-25 Add Argos component check and joint jog scripts; implement integration tests for dashboard bridge
    - Introduced `argos_component_check` script for preflight checks and ROS topic validation.
    - Added `argos_joint_jog` script to safely jog robot joints through the ESP32 bridge.
    - Created integration tests for `dashboard_bridge_node` to verify joint state outputs and clamping behavior.
2026-04-25 Enhance ADC initialization for gas sensor; improve compatibility across ESP32 variants
2026-04-26 Add ESP32 serial transport implementation for micro-ROS; include UART handling
2026-04-26 Add minimal setup and configuration for Pi and ESP32; update documentation and launch files
2026-04-28 initial imu mapping node using madgwick filter
